Squirrel-li/hear-your-heart/assets/software/資料流程圖.jpg

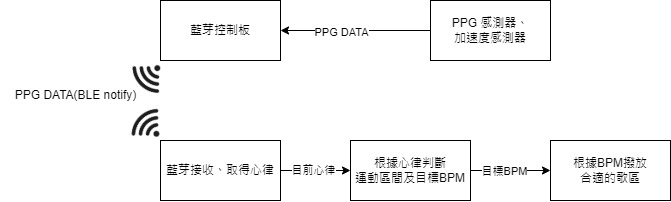
assets/software/資料流程圖.jpg
