Squirrel-li/hear-your-heart/docs/project-overview/system_architecture.png

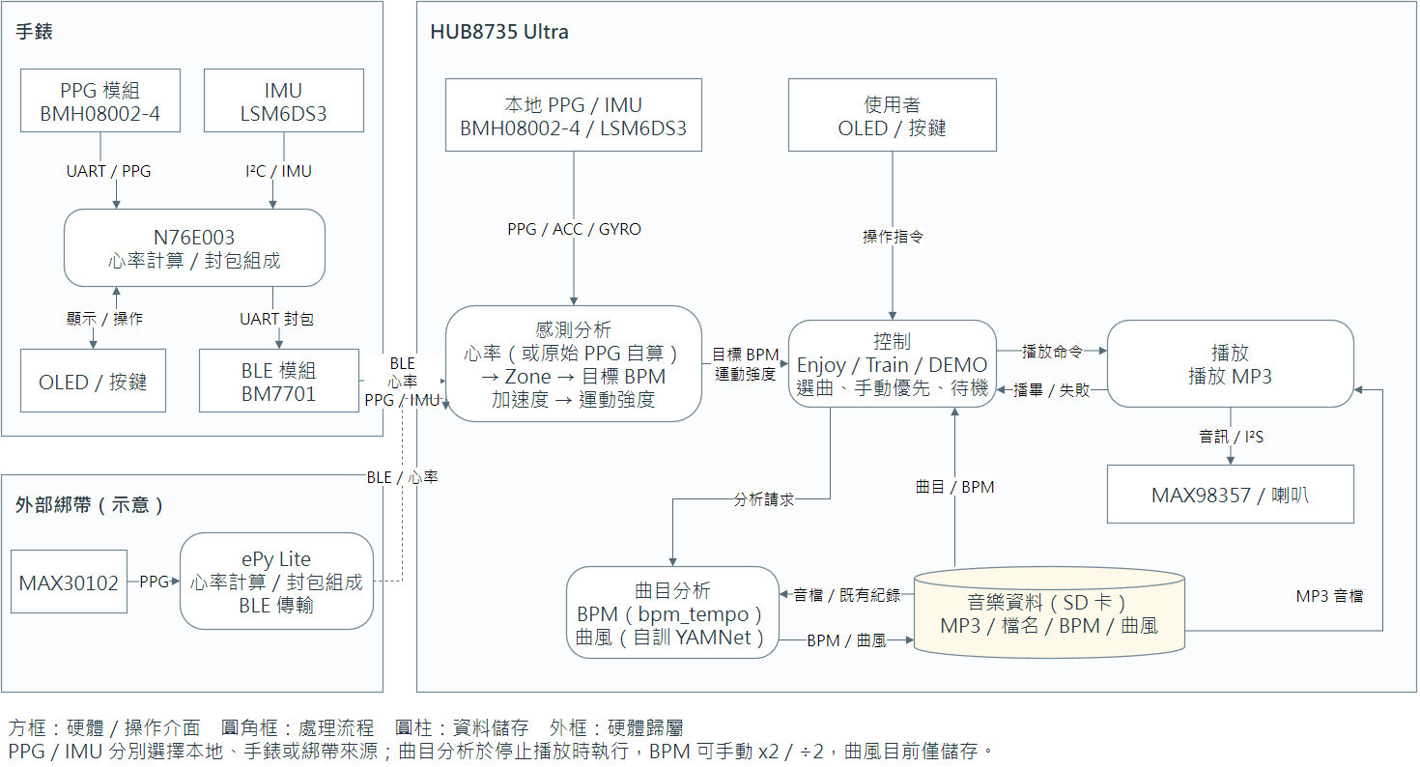
docs/project-overview/system_architecture.png
