Squirrel-li/hear-your-heart/docs/hub8735/hub_ui_steps/02.png

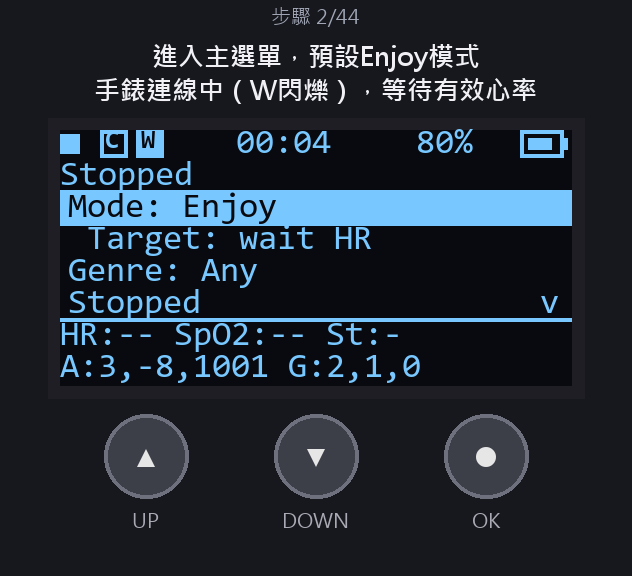
docs/hub8735/hub_ui_steps/02.png
