Squirrel-li/hear-your-heart/docs/hub8735/hub_ui_steps/11.png

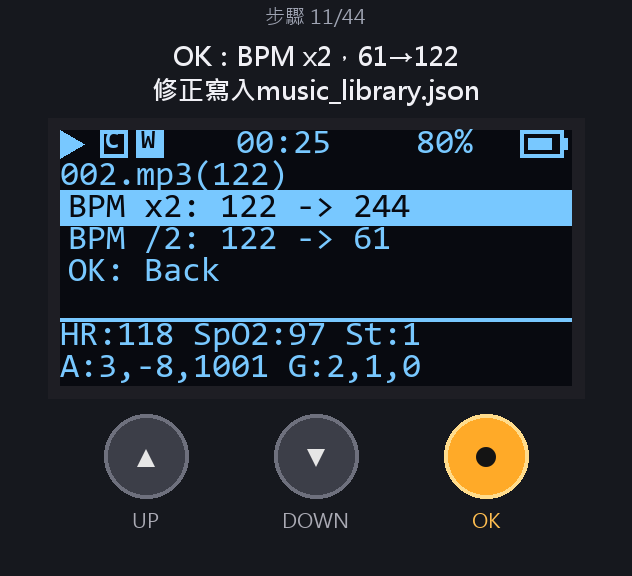
docs/hub8735/hub_ui_steps/11.png
