Squirrel-li/hear-your-heart/docs/hub8735/hub_ui_steps/33.png

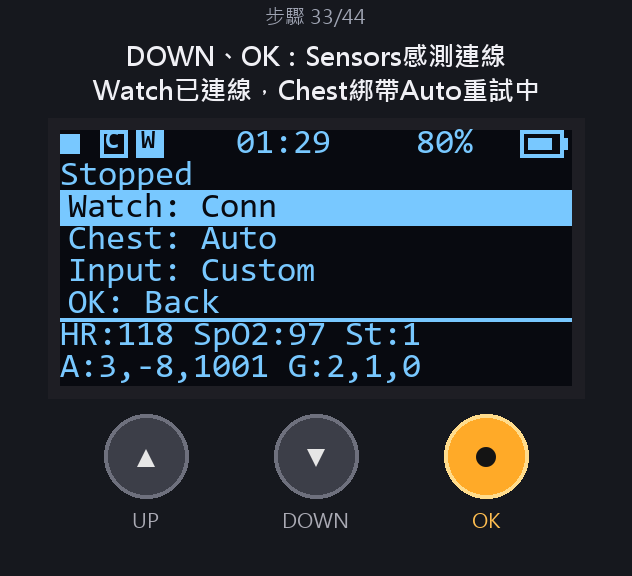
docs/hub8735/hub_ui_steps/33.png
