Squirrel-li/hear-your-heart/docs/hub8735/hub_ui_steps/34.png

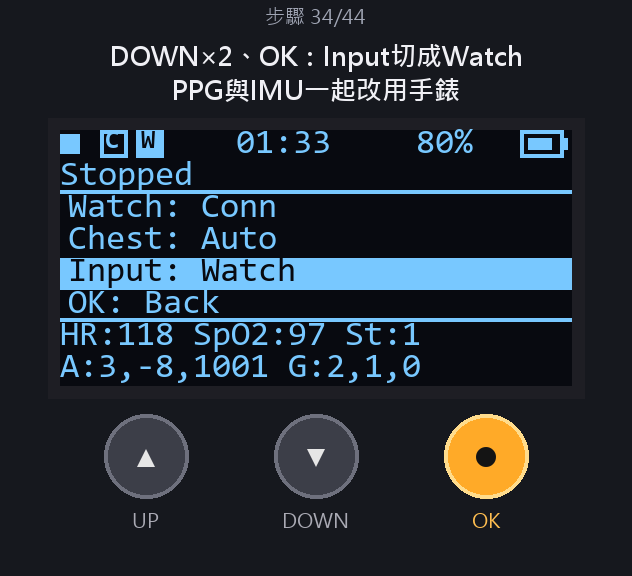
docs/hub8735/hub_ui_steps/34.png
