Squirrel-li/hear-your-heart/docs/hub8735/hub_ui_steps/37.png

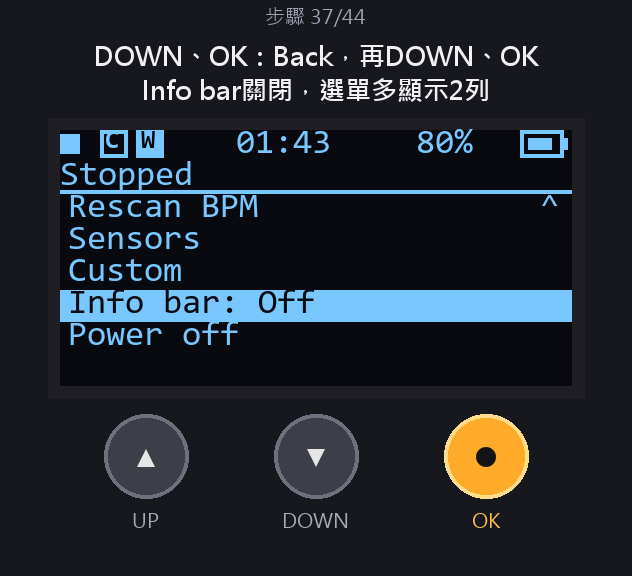
docs/hub8735/hub_ui_steps/37.png
