Squirrel-li/hear-your-heart/docs/hub8735/hub_ui_steps/44.png

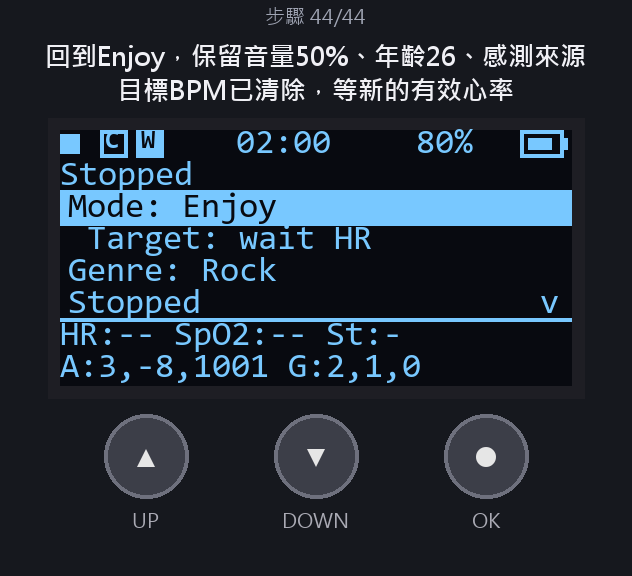
docs/hub8735/hub_ui_steps/44.png
