Squirrel-li/hear-your-heart/docs/hub8735/hub_ui_steps/hub_ui_operation.gif

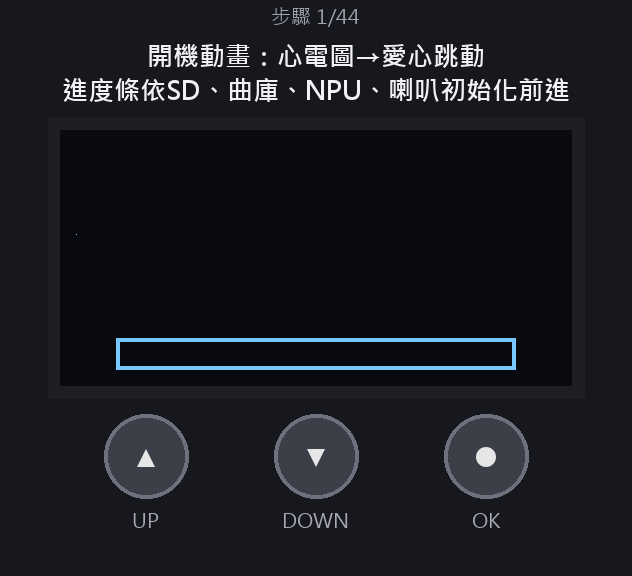
docs/hub8735/hub_ui_steps/hub_ui_operation.gif
