Squirrel-li/hear-your-heart/firmware/n76e003/scripts/ble-test.html

# BM7701 控制與 BLE 測試

本頁由 bm7701.ps1 -Command Web 提供：左側透過腳本控制 UART，右側使用這台電腦的 Bluetooth 測試 BLE 服務。

## 1 · BM7701 UART 控制

正在連接 bm7701.ps1 Web API…

讀取版本 讀取狀態 開始廣播 停止廣播

Bluetooth 名稱設定名稱

功率代碼（0–15）設定功率

網頁不直接開啟 COM；若 API 未連線，請先在 PowerShell 執行 Web 模式。

## 2 · UART → BLE 通知（FFF1）

格式 資料00 01 02 03 04 05 06 07 08 09

發送發送並比對通知

Counter 筆數 間隔（ms）

發送 counter發送並驗證 counter

「比對／驗證」需先在右側連線並開啟 FFF1 通知。UART ACK 只代表模組收到命令，送達與否以 BLE 通知為準。

## 3 · 電腦 BLE 連線

額外 Service UUID（逗號或空白分隔；FFF0 已包含）

選擇 BM7701 並連線斷線讀取所有可讀值

尚未連線

只列出本次授權且 Chrome 允許存取的服務，並非完整 GATT 清單；新增 UUID 後需重新選擇裝置。重新連線後請重新訂閱。

## 4 · 資料與驗證

格式 BLE 寫入資料／通知預期值00 01 02 03 04 05 06 07 08 09

填入固定 10 bytes比對下一筆 FFF1 通知開始驗證 counter結束 counter 並判定

尚未開始比對。先在下方 FFF1 開啟通知，再從 UART 送出資料。

固定資料逐 byte 比對。Counter 格式：42 4D + 16-bit LE 序號（0 起，筆數取左側設定）+ 00 01 02 03 04 05；收齊即自動判定，完整、無重複、無亂序才通過。其他通知不計入。

## 5 · Characteristics

連線後顯示 UUID、屬性與可用操作。

## 6 · 事件日誌

匯出日誌清除畫面日誌離線自我檢查

最多保留最近 2,000 筆；長測試請定期匯出。腳本 UART 事件以 SCRIPT 開頭。
