Squirrel-li/hear-your-heart/firmware/n76e003/application/ble_sensor_motion/public_test_results/windows.csv

record | mode | end_s | reference_center_s | phase | reference_bpm | bpm | valid | absolute_error | reason | quality | ir_bpm | red_bpm
DATA_01_TYPE01 | acc_assisted | 10.024 | 7.523999999999999 | rest_protocol | 76.95593406593406 | 77 | 1 | 0.04406593406594084 | 0 | 100 | 77 | 77
DATA_01_TYPE01 | acc_assisted | 15.036 | 12.536 | rest_protocol | 72.3405017921147 | 72 | 1 | 0.34050179211469356 | 0 | 100 | 70 | 70
DATA_01_TYPE01 | acc_assisted | 20.048 | 17.548 | rest_protocol | 73.32391885254185 | 74 | 1 | 0.6760811474581487 | 0 | 60 | 0 | 75
DATA_01_TYPE01 | acc_assisted | 25.06 | 22.56 | rest_protocol | 77.61560470151562 | 75 | 1 | 2.615604701515622 | 0 | 60 | 76 | 0
DATA_01_TYPE01 | acc_assisted | 30.072 | 27.572 | rest_protocol | 75.48998239584206 | 0 | 0 |  | 2 | 0 | 0 | 0
DATA_01_TYPE01 | acc_assisted | 35.084 | 32.584 | run_protocol | 70.27523548171773 | 67 | 1 | 3.275235481717729 | 0 | 83 | 68 | 66
DATA_01_TYPE01 | acc_assisted | 40.096 | 37.596 | run_protocol | 79.69778582308659 | 0 | 0 |  | 2 | 0 | 0 | 0
DATA_01_TYPE01 | acc_assisted | 45.108 | 42.608 | run_protocol | 83.86281025806029 | 0 | 0 |  | 2 | 0 | 0 | 0
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
