Squirrel-li/hear-your-heart/apps/bmh08002_ppg_analyzer/results/hr1_motion.csv

segment | end_s | fs_hz | bpm | quality | reason | mode | ir_bpm | red_bpm | removed_fraction | module_d3_bpm
1 | 10.005 | 35.7963 | 55.582213483566974 | 0.6125135936392285 | ok | ppg_only | 55.582213483566974 | 55.582213483566974 | 0.0 | 57.0
1 | 12.016 | 35.7963 | 0.0 | 0.0 | contact_or_gain_jump | ppg_only | 0.0 | 0.0 | 0.0 | 57.0
1 | 14.028 | 35.7963 | 59.25273701550065 | 0.6582956041171376 | ok | ppg_only | 58.728376510938695 | 59.777097520062604 | 0.0 | 57.0
1 | 16.039 | 35.7963 | 0.0 | 0.0 | ambiguous_spectrum | ppg_only | 0.0 | 0.0 | 0.0 | 57.0
1 | 18.051 | 35.7963 | 74.98355215235922 | 0.5049871758649533 | ok | ppg_only | 74.45919164779727 | 75.50791265692118 | 0.0 | 57.0
1 | 20.062 | 35.7963 | 0.0 | 0.0 | ambiguous_spectrum | ppg_only | 0.0 | 0.0 | 0.0 | 66.0
1 | 22.073 | 35.7963 | 0.0 | 0.0 | ambiguous_spectrum | ppg_only | 0.0 | 0.0 | 0.0 | 71.0
1 | 24.085 | 35.7963 | 0.0 | 0.0 | ambiguous_spectrum | ppg_only | 0.0 | 0.0 | 0.0 | 71.0
1 | 26.096 | 35.7963 | 60.30145802462455 | 0.6102117137805741 | ok | ppg_only | 60.825818529186506 | 59.777097520062604 | 0.0 | 71.0
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
