Squirrel-li/hear-your-heart/apps/bmh08002_ppg_analyzer/results/hr2_motion.csv

segment | end_s | fs_hz | bpm | quality | reason | mode | ir_bpm | red_bpm | removed_fraction | module_d3_bpm
1 | 10.027 | 35.7716 | 0.0 | 0.0 | contact_or_gain_jump | ppg_only | 0.0 | 0.0 | 0.0 | 73.0
1 | 12.04 | 35.7716 | 0.0 | 0.0 | contact_or_gain_jump | ppg_only | 0.0 | 0.0 | 0.0 | 73.0
1 | 14.053 | 35.7716 | 0.0 | 0.0 | contact_or_gain_jump | ppg_only | 0.0 | 0.0 | 0.0 | 73.0
1 | 16.065 | 35.7716 | 77.55171925710616 | 0.48944241785102627 | ok | ppg_only | 77.55171925710616 | 77.55171925710616 | 0.0 | 73.0
1 | 18.078 | 35.7716 | 0.0 | 0.0 | ambiguous_spectrum | ppg_only | 0.0 | 0.0 | 0.0 | 73.0
1 | 20.091 | 35.7716 | 0.0 | 0.0 | ambiguous_spectrum | ppg_only | 0.0 | 0.0 | 0.0 | 76.0
1 | 22.104 | 35.7716 | 79.64771166946039 | 0.5751282755788939 | ok | ppg_only | 79.64771166946039 | 79.64771166946039 | 0.0 | 80.0
1 | 24.116 | 35.7716 | 75.45572684475194 | 0.47310335031146206 | ok | ppg_only | 75.45572684475194 | 75.45572684475194 | 0.0 | 81.0
1 | 26.129 | 35.7716 | 70.21574581386639 | 0.5498941536758538 | ok | ppg_only | 70.21574581386639 | 70.21574581386639 | 0.0 | 81.0
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
