Squirrel-li/hear-your-heart/firmware/n76e003/application/ble_sensor_motion/test_results/clean_180.csv

time_ms | bpm | raw_bpm | quality | reason | ir_bpm | red_bpm | old_bpm | old_fresh
5012 | 0 | 0 | 0 | 1 | 181 | 181 | 0 | 0
10024 | 180 | 180 | 100 | 0 | 180 | 180 | 0 | 1
15036 | 181 | 181 | 100 | 0 | 181 | 181 | 0 | 0
20048 | 180 | 180 | 100 | 0 | 180 | 180 | 180 | 1
25060 | 180 | 180 | 100 | 0 | 180 | 180 | 180 | 0
30072 | 181 | 181 | 100 | 0 | 181 | 181 | 180 | 1
35084 | 180 | 180 | 100 | 0 | 180 | 180 | 180 | 0
40096 | 181 | 181 | 100 | 0 | 181 | 181 | 180 | 1
45108 | 180 | 180 | 100 | 0 | 180 | 180 | 180 | 0
50120 | 181 | 181 | 100 | 0 | 181 | 180 | 180 | 1
55132 | 181 | 181 | 100 | 0 | 180 | 181 | 180 | 0
