Squirrel-li/hear-your-heart/firmware/n76e003/application/ble_sensor_motion/test_results/clean_45.csv

time_ms | bpm | raw_bpm | quality | reason | ir_bpm | red_bpm | old_bpm | old_fresh
5012 | 0 | 0 | 0 | 1 | 45 | 45 | 0 | 0
10024 | 45 | 45 | 100 | 0 | 45 | 45 | 0 | 1
15036 | 45 | 45 | 100 | 0 | 45 | 45 | 0 | 0
20048 | 45 | 45 | 100 | 0 | 45 | 45 | 45 | 1
25060 | 45 | 45 | 100 | 0 | 45 | 45 | 45 | 0
30072 | 45 | 45 | 100 | 0 | 45 | 45 | 45 | 1
35084 | 46 | 46 | 100 | 0 | 45 | 46 | 45 | 0
40096 | 45 | 45 | 100 | 0 | 45 | 44 | 45 | 1
45108 | 45 | 45 | 100 | 0 | 45 | 45 | 45 | 0
50120 | 45 | 45 | 100 | 0 | 45 | 45 | 45 | 1
55132 | 45 | 45 | 100 | 0 | 45 | 45 | 45 | 0
