Squirrel-li/hear-your-heart/firmware/n76e003/application/ble_sensor_motion/test_results/hr1.csv

time_ms | bpm | raw_bpm | quality | reason | ir_bpm | red_bpm | old_bpm | old_fresh
5033 | 0 | 0 | 0 | 1 | 0 | 0 | 0 | 0
10033 | 56 | 56 | 100 | 0 | 56 | 56 | 0 | 1
15034 | 72 | 72 | 71 | 0 | 75 | 69 | 0 | 0
20034 | 0 | 0 | 0 | 2 | 0 | 0 | 73 | 1
25035 | 60 | 60 | 100 | 0 | 60 | 60 | 73 | 0
30035 | 59 | 59 | 100 | 0 | 58 | 59 | 59 | 1
