Squirrel-li/hear-your-heart/firmware/n76e003/application/ble_sensor_motion/test_results/hr2.csv

time_ms | bpm | raw_bpm | quality | reason | ir_bpm | red_bpm | old_bpm | old_fresh
5051 | 0 | 0 | 0 | 1 | 89 | 91 | 0 | 0
10055 | 70 | 70 | 71 | 0 | 69 | 71 | 0 | 1
15059 | 77 | 81 | 100 | 0 | 80 | 81 | 0 | 0
20063 | 80 | 81 | 100 | 0 | 81 | 81 | 80 | 1
25067 | 73 | 70 | 100 | 0 | 70 | 70 | 80 | 0
30071 | 70 | 69 | 100 | 0 | 68 | 69 | 69 | 1
35075 | 73 | 75 | 100 | 0 | 74 | 75 | 69 | 0
40079 | 69 | 67 | 100 | 0 | 67 | 66 | 71 | 1
45083 | 68 | 68 | 100 | 0 | 68 | 68 | 71 | 0
50087 | 66 | 65 | 100 | 0 | 65 | 65 | 67 | 1
55091 | 65 | 65 | 100 | 0 | 65 | 65 | 67 | 0
61702 | 0 | 0 | 0 | 1 | 72 | 72 | 67 | 0
66705 | 70 | 70 | 100 | 0 | 70 | 70 | 67 | 0
