Squirrel-li/hear-your-heart/firmware/remote_sensor/scripts/ble-test.html

# BM7701 控制與 BLE 測試

本頁由 bm7701.ps1 -Command Web 提供：UART 控制走同一個腳本，BLE 服務測試使用這台電腦的內建 Bluetooth。

## UART 發送資料

格式 資料00 01 02 03 04 05 06 07 08 09

## 1 · BM7701 UART 控制

讀取腳本狀態讀取版本讀取狀態開始廣播停止廣播

Bluetooth 名稱 功率代碼（0–15）

設定名稱設定功率由 UART 發送目前資料到 FFF1由 UART 發送 counter

Counter 筆數 Counter 間隔（ms） 尚未連接 bm7701.ps1 Web API

網頁不直接開啟 COM。若 API 尚未啟動，請先在 PowerShell 執行 Web 模式；本區按鈕只呼叫固定的 BM7701 操作。

## 2 · 電腦接收／BLE 操作

額外 Service UUID（逗號或空白分隔；FFF0 已包含）

選擇 BM7701 並連線斷線讀取所有可讀值匯出日誌離線自我檢查

尚未連線

只列出本次授權且 Chrome 允許存取的服務，並非完整 GATT 清單。新增 UUID 後需重新選擇裝置。請在電腦的 Bluetooth 裝置選擇器選 BM7701；重新連線後請重新訂閱。

## 3 · 資料與驗證

資料格式 寫入資料／通知預期值00 01 02 03 04 05 06 07 08 09

填入固定 10 bytes比對下一筆 FFF1 通知開始驗證 100 筆 FFF1 counter結束 counter 並判定

尚未開始比對。先在下方 FFF1 開啟通知，再從電腦送出資料。

固定資料逐 byte 比對。Counter 格式：42 4D + 16-bit LE 序號（0–99）+ 00 01 02 03 04 05。按「開始驗證」後可按上方「由 UART 發送 counter」；完整、無重複、無亂序才通過。其他通知不計入 FFF1 測試。

## 4 · Characteristics

連線後顯示 UUID、屬性與可用操作。

## 5 · 事件日誌

最多保留最近 2,000 筆；長測試請定期匯出。腳本 UART 事件會以 SCRIPT 顯示，BLE 操作會以 BLE 顯示。
