Squirrel-li/hear-your-heart/firmware/hub8735-ultra/application/embedded_loudspeaker/ControlTask.h

#ifndef CONTROL_TASK_H
#define CONTROL_TASK_H

#include <Arduino.h>
#include <FreeRTOS.h>
#include <task.h>
#include <queue.h>

#include "debug.h"
#include "globalData.h"

void controlTask(void* parameter);

// User age (HRmax) kept in flash; controlTask owns it. setup() reads it before the tasks start.
int settingsLoadAge();

#endif // CONTROL_TASK_H
