Squirrel-li/hear-your-heart/firmware/hub8735-ultra/application/embedded_loudspeaker/UITask.cpp

#include "UITask.h"

#include "debug.h"
#include "globalData.h"
#include "music_library.h"
#include "oled_sh1106.h"
#include "motion_level.h"
#include "train_plan.h"

namespace {

constexpr const char* TAG = "UI";
uint32_t droppedCommands = 0;

// OLED on Wire (I2C0: SDA=D3/PE4, SCL=D4/PE3).
constexpr uint8_t OLED_ADDRESS = 0x3C;

// Buttons wired between pin and GND (internal pull-up, pressed = LOW).
constexpr uint8_t PIN_UP = 8;
constexpr uint8_t PIN_DOWN = 9;
constexpr uint8_t PIN_OK = 10;
constexpr uint8_t PIN_BATTERY = 2;  // ADC0, battery through a /2 divider

constexpr uint32_t POLL_MS = 10;
constexpr uint32_t REDRAW_MS = 50;
constexpr uint32_t MARQUEE_MS = 300;  // a long name scrolls one column per step
constexpr int MARQUEE_GAP = 3;        // blank columns between the end and the restart of a scrolled name
// Full resend (and placement registers) so a glitched I2C transfer heals by itself.
constexpr uint32_t REFRESH_MS = 2000;

// Layout (6x8 font, 21 columns, 8 rows aligned to the panel's 8-pixel pages so an
// update only resends the pages that changed): icon row, now playing, 4 menu rows, 2 info
// rows (6 menu rows with the info bar off). The font leaves the bottom pixel row of each cell
// empty, which holds the lines.
constexpr int16_t ICON_Y = 0;
constexpr int16_t SONG_Y = 8;
constexpr int16_t HEADER_LINE_Y = 15;
constexpr int16_t MENU_Y = 16;
constexpr int16_t DIVIDER_Y = 47;
constexpr int16_t STATUS_Y[2] = {48, 56};

// Rows depend on the mode: TopGenre in Enjoy / Train, TopSongBpm while a library song
// plays. The Top cursor is a row; topItemAt() maps it to an item.
enum TopItem : uint8_t {
    TopMode,
    TopGenre,
    TopPlay,
    TopSongBpm,
    TopSongs,
    TopStop,
    TopVolume,
    TopAge,
    TopBpmAnalysis,
    TopBle,
    TopInput,
    TopDebug,
    TopPowerOff,
    TopCount
};

// Top: mode, play/pause, stop, volume, and BPM analysis. ModeList / VolumeList: pick a value with OK, which also leaves the list.
enum class Screen : uint8_t {
    Top,
    ModeList,
    PlanList,      // Train plans, opened when Train is picked in ModeList
    VolumeList,
    GenreList,     // preferred genre for Enjoy / Train; OK picks it and leaves
    BpmStatus,
    SongList,
    SongMenu,      // one song: [Play] / BPM x2 / BPM /2 / Back (Play only from SongList in Manual)
    BleList,       // Watch / Chest link (OK toggles Auto/Off); Back
    CustomList,    // opened when Top Input reaches Custom: PPG / IMU (OK cycles each); Back
    PowerConfirm,  // Cancel / Power off
    AgeEdit,       // Up/Down change the age, OK saves it (controlTask writes flash)
    DebugList,     // Info bar (OK toggles) / Analysis / Back
    AnalysisList,  // Reanalyze all / Clear all (both open AnalysisConfirm) / Clear one song (SongList) / Back
    AnalysisConfirm  // Cancel / Confirm for the action picked in AnalysisList
};

constexpr uint8_t MODE_COUNT = 4;  // PlayMode values in order: Enjoy, Train, Manual, Demo
constexpr uint8_t SOURCE_COUNT = 3;  // Chest, Watch, Local
constexpr uint8_t POWER_CONFIRM_COUNT = 2;
constexpr uint8_t VOLUME_STEP = 10;
constexpr uint8_t VOLUME_COUNT = 100 / VOLUME_STEP + 1;

struct Button {
    uint8_t pin;
    uint8_t history;  // last 8 samples, 1 = pressed
    bool down;
};

OledSh1106 oled(&Wire, OLED_ADDRESS);

Button buttons[3] = {{PIN_UP, 0, false}, {PIN_DOWN, 0, false}, {PIN_OK, 0, false}};

Screen screen = Screen::Top;
uint16_t cursor = TopMode;
uint16_t menuTop = 0;

// Mirrors the choice sent to analysisTask (PPG starts on Watch, IMU on Local).
SensorSource ppgSource = SensorSource::Watch;
SensorSource imuSource = SensorSource::Local;
bool customInput = true;  // PPG and IMU picked separately; the boot pair (Watch, Local) differs

// Reported by controlTask / audioTask.
PlayMode playMode = PlayMode::Enjoy;
uint8_t trainPlan = 0;
uint8_t trainStage = TRAIN_STAGE_DONE;
uint16_t trainRemainingS = 0;
bool trainDone = false;  // shown until the mode changes again
uint16_t targetBpm = 0;  // Enjoy: 0 until a valid heart rate gives a target
uint8_t motionLevel = MOTION_LEVEL_NONE;  // Demo
AudioState audioState = AudioState::Stopped;
char nowPlaying[AUDIO_FILENAME_MAX] = "";
// ponytail: Volume is mirrored from menu changes only; the serial "volume" command
// can make it differ. Have audioTask report the volume if that matters.
uint8_t volumePercent = DEFAULT_VOLUME_PERCENT;
BpmAnalysisState bpmAnalysisState = BpmAnalysisState::Idle;
BpmAnalysisMode bpmAnalysisMode = BpmAnalysisMode::NewOrUnknown;
uint16_t bpmAnalysisCurrent = 0;
uint16_t bpmAnalysisTotal = 0;
uint16_t bpmAnalysisSucceeded = 0;
uint16_t bpmAnalysisFailed = 0;
char bpmAnalysisFile[AUDIO_FILENAME_MAX] = "";

uint32_t lastRefreshMs = 0;
bool infoBar = true;  // bottom HR / IMU rows; not saved, back on after reboot
int16_t songMenuIndex = -1;     // musicLibrary index shown in SongMenu
bool songMenuFromList = false;  // SongMenu opened from SongList (Back returns to the list)
enum SongMenuItem : uint8_t { SongPlay, SongDouble, SongHalve, SongBack };
bool powerOffRequested = false;  // set by the confirm screen, handled in the UITask loop
uint8_t ageEdit = USER_AGE_DEFAULT;  // value shown while AgeEdit is open
uint8_t preferredGenre = 0;  // mirrors the SetGenre sent to controlTask (GENRE_CHOICES index)
uint32_t okPressMs = 0;  // OKT latency log: time of the last OK press, 0 = none
// BpmStatus rows: state, progress, file, Back. View only: a scan is cancelled by serial "bpm cancel" or standby.
constexpr uint16_t BPM_STATUS_BACK = 3;
enum DebugItem : uint8_t { DebugInfoBar, DebugAnalysis, DebugBack };
enum AnalysisItem : uint8_t { AnalysisReanalyzeAll, AnalysisClearAll, AnalysisClearOne, AnalysisBack };
bool songListClear = false;  // SongList opened from AnalysisClearOne: OK on a song clears its BPM and genre
uint8_t analysisConfirmItem = AnalysisReanalyzeAll;  // action AnalysisConfirm asks about

// Reported by BLETask, index = SensorSource (Chest, Watch).
BleLinkState bleLink[2] = {BleLinkState::Down, BleLinkState::Down};
bool bleAuto[2] = {true, true};
bool havePpg = false;
uint16_t heartRate = 0;
uint8_t spo2 = 0;
uint8_t ppgStatus = 0;
bool haveAcc = false;
bool haveGyro = false;
int16_t acc[3] = {0, 0, 0};
int16_t gyro[3] = {0, 0, 0};

const char* sourceLabel(SensorSource source)
{
    return source == SensorSource::Chest ? "Chest" : source == SensorSource::Watch ? "Watch" : "Local";
}

const char* modeName(PlayMode mode)
{
    switch (mode) {
    case PlayMode::Enjoy: return "Enjoy";
    case PlayMode::Train: return "Train";
    case PlayMode::Demo: return "Demo";
    default: return "Manual";
    }
}

// Library index of the song being played or paused, -1 when stopped or not in the library (DEMO tracks).
int16_t playingLibraryIndex()
{
    if (audioState == AudioState::Stopped) return -1;
    for (size_t i = 0; i < musicLibrary.count && i < MUSIC_LIBRARY_MAX; ++i)
        if (strcmp(musicLibrary.entries[i].file, nowPlaying) == 0) return static_cast<int16_t>(i);
    return -1;
}

// x2 / /2 target for a song's BPM, 0 when unknown or outside 30..300.
uint16_t scaledBpm(uint16_t bpm, bool doubled)
{
    if (bpm == 0) return 0;
    const uint16_t v = doubled ? static_cast<uint16_t>(bpm * 2) : static_cast<uint16_t>((bpm + 1) / 2);
    return v >= 30 && v <= 300 ? v : 0;
}

// Picking a song to play is Manual only; automatic modes can view the list and fix BPM (x2 / /2).
bool songMenuHasPlay() { return songMenuFromList && playMode == PlayMode::Manual; }
uint16_t songMenuBackRow() { return songMenuHasPlay() ? 3 : 2; }  // the menu opens on Back
uint8_t songMenuItemAt(uint16_t row) { return static_cast<uint8_t>(songMenuHasPlay() ? row : row + 1); }

bool topItemVisible(uint8_t item)
{
    if (item == TopSongBpm) return playingLibraryIndex() >= 0;
    if (item == TopGenre) return playMode == PlayMode::Enjoy || playMode == PlayMode::Train;
    return true;
}

uint16_t topRowCount()
{
    uint16_t n = 0;
    for (uint8_t i = 0; i < TopCount; ++i) n += topItemVisible(i) ? 1 : 0;
    return n;
}

uint8_t topItemAt(uint16_t row)
{
    for (uint8_t i = 0; i < TopCount; ++i) {
        if (!topItemVisible(i)) continue;
        if (row-- == 0) return i;
    }
    return TopMode;
}

uint16_t topRowOf(uint8_t item)
{
    uint16_t row = 0;
    for (uint8_t i = 0; i < item && i < TopCount; ++i) row += topItemVisible(i) ? 1 : 0;
    return topItemVisible(item) ? row : 0;
}

// Entries are added or removed only while musicBpmAnalysisBusy (directory scan, clear); the list
// is not offered then. Row 0 is Back, row i + 1 is song i (UP from the first song reaches Back).
uint16_t songCount()
{
    const size_t n = musicLibrary.count > MUSIC_LIBRARY_MAX ? MUSIC_LIBRARY_MAX : musicLibrary.count;
    return static_cast<uint16_t>(n + 1);
}

bool bpmAnalysisActive()
{
    return bpmAnalysisState == BpmAnalysisState::Queued || bpmAnalysisState == BpmAnalysisState::Running;
}

uint16_t itemCount()
{
    switch (screen) {
    case Screen::ModeList: return MODE_COUNT;
    case Screen::PlanList: return TRAIN_PLAN_COUNT;
    case Screen::VolumeList: return VOLUME_COUNT;
    case Screen::GenreList: return GENRE_CHOICE_COUNT;
    case Screen::BpmStatus: return BPM_STATUS_BACK + 1;
    case Screen::AgeEdit: return 1;
    case Screen::SongList: return songCount();
    case Screen::SongMenu: return songMenuHasPlay() ? 4 : 3;
    case Screen::BleList: return 3;
    case Screen::CustomList: return 3;
    case Screen::PowerConfirm: return POWER_CONFIRM_COUNT;
    case Screen::DebugList: return DebugBack + 1;
    case Screen::AnalysisList: return AnalysisBack + 1;
    case Screen::AnalysisConfirm: return 2;
    default: return topRowCount();
    }
}
// True once on the sample that completes a stable press (40 ms debounce).
bool buttonPressed(Button& b)
{
    b.history = static_cast<uint8_t>((b.history << 1) | (digitalRead(b.pin) == LOW));
    if ((b.history & 0x0F) == 0x0F && !b.down) {
        b.down = true;
        return true;
    }
    if ((b.history & 0x0F) == 0) b.down = false;
    return false;
}

const char* screenName(Screen value)
{
    switch (value) {
    case Screen::Top: return "Top";
    case Screen::ModeList: return "ModeList";
    case Screen::PlanList: return "PlanList";
    case Screen::VolumeList: return "VolumeList";
    case Screen::GenreList: return "GenreList";
    case Screen::BpmStatus: return "BpmStatus";
    case Screen::SongList: return "SongList";
    case Screen::SongMenu: return "SongMenu";
    case Screen::BleList: return "BleList";
    case Screen::CustomList: return "CustomList";
    case Screen::PowerConfirm: return "PowerConfirm";
    case Screen::AgeEdit: return "AgeEdit";
    case Screen::DebugList: return "DebugList";
    case Screen::AnalysisList: return "AnalysisList";
    case Screen::AnalysisConfirm: return "AnalysisConfirm";
    }
    return "?";
}

const char* topItemName(uint8_t item)
{
    switch (item) {
    case TopMode: return "Mode";
    case TopGenre: return "Genre";
    case TopPlay: return "Play/Pause";
    case TopSongBpm: return "Song BPM";
    case TopSongs: return "Songs";
    case TopStop: return "Stop";
    case TopVolume: return "Volume";
    case TopAge: return "Age";
    case TopBpmAnalysis: return "BPM analysis";
    case TopBle: return "BLE";
    case TopInput: return "Input";
    case TopDebug: return "Debug";
    case TopPowerOff: return "Power off";
    }
    return "?";
}

const char* linkLabel(BleLinkState state)
{
    return state == BleLinkState::Up ? "Conn" : state == BleLinkState::Connecting ? "Scan" : "--";
}

// BLETask reports the result; the menu shows it on the next Ble update.
void sendBleCommand(BleCommandType type, uint8_t device)
{
    const BleCmdElement command{type, static_cast<SensorSource>(device)};
    if (bleCmdQueue == nullptr || xQueueSend(bleCmdQueue, &command, 0) != pdPASS) {
        ++droppedCommands;
        LOGW(TAG, "BLE command queue full; command %d dropped", static_cast<int>(type));
        return;
    }
    LOGI(TAG, "-> BLE: command %d device %u", static_cast<int>(type), static_cast<unsigned>(device));
}

bool sendCommand(UiCommandType type, uint8_t volume = 0, PlayMode mode = PlayMode::Enjoy,
                 int16_t songIndex = -1, SensorSource source = SensorSource::Chest, uint8_t plan = 0,
                 uint16_t bpm = 0, uint8_t age = 0, uint8_t genre = 0)
{
    UiCommandElement command{};
    command.age = age;
    command.genre = genre;
    command.bpm = bpm;
    command.command = type;
    command.trainPlan = plan;
    command.source = source;
    command.volumePercent = volume;
    command.mode = mode;
    command.songIndex = songIndex;
    if (uiCmdQueue == nullptr || xQueueSend(uiCmdQueue, &command, 0) != pdPASS) {
        ++droppedCommands;
        LOGW(TAG, "control command queue full; command %d dropped (total dropped %lu)", static_cast<int>(type),
             static_cast<unsigned long>(droppedCommands));
        return false;
    }
    LOGD(TAG, "-> control: command %d (volume=%u mode=%s)", static_cast<int>(type), static_cast<unsigned>(volume),
         modeName(mode));
    return true;
}

// The mirror changes only once controlTask has the command.
bool setSensorSource(bool isPpg, SensorSource source)
{
    if (!sendCommand(isPpg ? UiCommandType::SetPpgSource : UiCommandType::SetImuSource, 0, PlayMode::Enjoy, -1,
                     source))
        return false;
    (isPpg ? ppgSource : imuSource) = source;
    return true;
}

void openList(Screen list, uint16_t selected)
{
    LOGD(TAG, "screen %s -> %s (cursor %u)", screenName(screen), screenName(list), static_cast<unsigned>(selected));
    screen = list;
    cursor = selected;
    menuTop = 0;
}

void backToTop(TopItem item)
{
    LOGD(TAG, "screen %s -> Top (cursor %s)", screenName(screen), topItemName(item));
    screen = Screen::Top;
    cursor = topRowOf(item);
    menuTop = 0;
}

void showBpmStatus()
{
    screen = Screen::BpmStatus;
    cursor = BPM_STATUS_BACK;
    menuTop = 0;
}

// Starts a scan and shows its progress; while one is queued or running, only shows it.
void startBpmScan(BpmAnalysisMode mode)
{
    if (bpmAnalysisActive()) {
        LOGD(TAG, "BPM analysis already active; showing status");
        showBpmStatus();
        return;
    }
    LOGI(TAG, "BPM %s requested from menu", mode == BpmAnalysisMode::All ? "reanalyze all" : "rescan");
    bpmAnalysisMode = mode;
    bpmAnalysisState = BpmAnalysisState::Queued;
    bpmAnalysisCurrent = 0;
    bpmAnalysisTotal = 0;
    bpmAnalysisSucceeded = 0;
    bpmAnalysisFailed = 0;
    bpmAnalysisFile[0] = 0;
    if (!sendCommand(mode == BpmAnalysisMode::All ? UiCommandType::ReanalyzeAllBpm
                                                  : UiCommandType::AnalyzeNewOrUnknownBpm)) {
        bpmAnalysisState = BpmAnalysisState::Failed;
        bpmAnalysisFailed = 1;
    }
    showBpmStatus();
}

// Long OK: leave the current list one level up without applying its highlighted row.
void goBack()
{
    LOGI(TAG, "OK held: back from %s", screenName(screen));
    switch (screen) {
    case Screen::Top: break;
    case Screen::ModeList: backToTop(TopMode); break;
    case Screen::PlanList: openList(Screen::ModeList, static_cast<uint8_t>(PlayMode::Train)); break;
    case Screen::VolumeList: backToTop(TopVolume); break;
    case Screen::GenreList: backToTop(TopGenre); break;
    case Screen::AgeEdit: backToTop(TopAge); break;  // the edit is dropped
    case Screen::BpmStatus: backToTop(TopBpmAnalysis); break;
    case Screen::SongList:
        if (songListClear) openList(Screen::AnalysisList, AnalysisClearOne);
        else backToTop(TopSongs);
        break;
    case Screen::SongMenu:
        if (songMenuFromList && songMenuIndex >= 0) openList(Screen::SongList, static_cast<uint16_t>(songMenuIndex + 1));
        else backToTop(songMenuFromList ? TopSongs : TopSongBpm);
        break;
    case Screen::BleList: backToTop(TopBle); break;
    case Screen::CustomList: backToTop(TopInput); break;
    case Screen::PowerConfirm: backToTop(TopPowerOff); break;
    case Screen::DebugList: backToTop(TopDebug); break;
    case Screen::AnalysisList: openList(Screen::DebugList, DebugAnalysis); break;
    case Screen::AnalysisConfirm: openList(Screen::AnalysisList, analysisConfirmItem); break;
    }
}

void activateItem()
{
    LOGI(TAG, "OK pressed: screen=%s cursor=%u%s%s", screenName(screen), static_cast<unsigned>(cursor),
         screen == Screen::Top ? " item=" : "", screen == Screen::Top ? topItemName(topItemAt(cursor)) : "");
    switch (screen) {
    case Screen::ModeList:
        if (static_cast<PlayMode>(cursor) == PlayMode::Train) {
            openList(Screen::PlanList, trainPlan);
            break;
        }
        sendCommand(UiCommandType::SetMode, 0, static_cast<PlayMode>(cursor));
        backToTop(TopMode);
        break;
    case Screen::PlanList:
        sendCommand(UiCommandType::SetMode, 0, PlayMode::Train, -1, SensorSource::Chest, static_cast<uint8_t>(cursor));
        backToTop(TopMode);
        break;
    case Screen::VolumeList:
        backToTop(TopVolume);
        break;
    case Screen::GenreList:
        if (cursor != preferredGenre &&
            sendCommand(UiCommandType::SetGenre, 0, PlayMode::Enjoy, -1, SensorSource::Chest, 0, 0, 0,
                        static_cast<uint8_t>(cursor))) {
            preferredGenre = static_cast<uint8_t>(cursor);
        }
        backToTop(TopGenre);
        break;
    case Screen::AgeEdit:
        if (ageEdit != userInfo.age) {
            LOGI(TAG, "age %d -> %u requested", userInfo.age, static_cast<unsigned>(ageEdit));
            sendCommand(UiCommandType::SetAge, 0, PlayMode::Enjoy, -1, SensorSource::Chest, 0, 0, ageEdit);
        }
        backToTop(TopAge);
        break;
    case Screen::BpmStatus:
        backToTop(TopBpmAnalysis);  // the scan keeps running in the background
        break;
    case Screen::SongList:
        if (cursor >= 1 && cursor <= musicLibrary.count && songListClear) {
            // Stays open: the row shows "--" once audioTask has saved it.
            sendCommand(UiCommandType::SetSongBpm, 0, PlayMode::Enjoy, static_cast<int16_t>(cursor - 1));
        } else if (cursor >= 1 && cursor <= musicLibrary.count) {
            songMenuIndex = static_cast<int16_t>(cursor - 1);
            songMenuFromList = true;
            openList(Screen::SongMenu, songMenuBackRow());
        } else if (songListClear) {
            openList(Screen::AnalysisList, AnalysisClearOne);
        } else {
            backToTop(TopSongs);
        }
        break;
    case Screen::SongMenu: {
        const uint8_t item = songMenuItemAt(cursor);
        const bool valid = songMenuIndex >= 0 && songMenuIndex < static_cast<int16_t>(musicLibrary.count);
        if (item == SongPlay && valid) {
            sendCommand(UiCommandType::PlaySong, 0, PlayMode::Enjoy, songMenuIndex);
            backToTop(TopSongs);
        } else if ((item == SongDouble || item == SongHalve) && valid) {
            // Stays open: audioTask saves the library and the label shows the new value.
            const uint16_t bpm = scaledBpm(musicLibrary.entries[songMenuIndex].bpm, item == SongDouble);
            if (bpm != 0) sendCommand(UiCommandType::SetSongBpm, 0, PlayMode::Enjoy, songMenuIndex, SensorSource::Chest, 0, bpm);
        } else if (songMenuFromList && valid) {
            openList(Screen::SongList, static_cast<uint16_t>(songMenuIndex + 1));
        } else {
            backToTop(songMenuFromList ? TopSongs : TopSongBpm);
        }
        break;
    }
    case Screen::BleList:
        if (cursor >= 2) {
            backToTop(TopBle);
        } else {
            // Watch row first; Auto keeps (re)connecting, Disconnect drops the link and turns Auto off.
            const uint8_t device = cursor == 0 ? 1 : 0;
            sendBleCommand(bleAuto[device] ? BleCommandType::Disconnect : BleCommandType::SetAuto, device);
        }
        break;
    case Screen::CustomList:
        if (cursor >= 2) {
            backToTop(TopInput);
        } else {
            // OK cycles PPG or IMU alone (Chest -> Watch -> Local).
            const bool isPpg = cursor == 0;
            const SensorSource current = isPpg ? ppgSource : imuSource;
            setSensorSource(isPpg, static_cast<SensorSource>((static_cast<uint8_t>(current) + 1) % SOURCE_COUNT));
        }
        break;
    case Screen::PowerConfirm:
        // Standby starts only once controlTask has the command.
        if (cursor == 1 && sendCommand(UiCommandType::PowerOff)) powerOffRequested = true;
        else backToTop(TopPowerOff);
        break;
    case Screen::DebugList:
        if (cursor == DebugInfoBar) infoBar = !infoBar;
        else if (cursor == DebugAnalysis) openList(Screen::AnalysisList, 0);
        else backToTop(TopDebug);
        break;
    case Screen::AnalysisList:
        if (cursor == AnalysisBack) {
            openList(Screen::DebugList, DebugAnalysis);
        } else if (cursor == AnalysisClearOne) {
            if (musicLibraryReady && !musicBpmAnalysisBusy && musicLibrary.count > 0) {
                songListClear = true;
                openList(Screen::SongList, 1);
            }
        } else {
            analysisConfirmItem = static_cast<uint8_t>(cursor);
            openList(Screen::AnalysisConfirm, 0);  // default to Cancel: both drop the user's BPM corrections
        }
        break;
    case Screen::AnalysisConfirm:
        if (cursor == 0) {
            openList(Screen::AnalysisList, analysisConfirmItem);
        } else if (analysisConfirmItem == AnalysisReanalyzeAll) {
            startBpmScan(BpmAnalysisMode::All);
        } else {
            LOGI(TAG, "clear all BPM / genre results requested from menu");
            sendCommand(UiCommandType::ClearAnalysisResults);  // audioTask cancels a running scan first
            openList(Screen::AnalysisList, AnalysisClearAll);
        }
        break;
    default:
        switch (topItemAt(cursor)) {
        case TopMode:
            openList(Screen::ModeList, static_cast<uint8_t>(playMode));
            break;
        case TopGenre:
            openList(Screen::GenreList, preferredGenre);
            break;
        case TopPlay:
            if (audioState == AudioState::Playing) sendCommand(UiCommandType::Pause);
            else if (audioState == AudioState::Paused) sendCommand(UiCommandType::Resume);
            break;
        case TopSongBpm:
            songMenuIndex = playingLibraryIndex();
            songMenuFromList = false;
            if (songMenuIndex >= 0) openList(Screen::SongMenu, songMenuBackRow());
            break;
        case TopSongs:
            if (musicLibraryReady && !musicBpmAnalysisBusy && musicLibrary.count > 0) {
                songListClear = false;
                openList(Screen::SongList, 1);  // first song
            } else {
                LOGD(TAG, "song list unavailable (ready=%d busy=%d count=%u)", musicLibraryReady ? 1 : 0,
                     musicBpmAnalysisBusy ? 1 : 0, static_cast<unsigned>(musicLibrary.count));
            }
            break;
        case TopStop:
            sendCommand(UiCommandType::Stop);
            break;
        case TopVolume:
            openList(Screen::VolumeList, 0);
            break;
        case TopAge:
            ageEdit = static_cast<uint8_t>(userInfo.age);
            openList(Screen::AgeEdit, 0);
            break;
        case TopBpmAnalysis:
            // One-button rescan: new / replaced / unknown only; reanalyze-all and clear are under Debug.
            startBpmScan(BpmAnalysisMode::NewOrUnknown);
            break;
        case TopBle:
            openList(Screen::BleList, 0);
            break;
        case TopInput:
            // OK cycles Watch -> Chest -> Local (PPG and IMU together) -> Custom, which opens the PPG / IMU list.
            if (customInput) {
                const bool ppgOk = setSensorSource(true, SensorSource::Watch);
                // A dropped command leaves PPG and IMU apart: they stay Custom.
                customInput = !(setSensorSource(false, SensorSource::Watch) && ppgOk);
            } else if (ppgSource == SensorSource::Local) {
                customInput = true;
                openList(Screen::CustomList, 0);
            } else {
                const SensorSource s = ppgSource == SensorSource::Watch ? SensorSource::Chest : SensorSource::Local;
                const bool ppgOk = setSensorSource(true, s);
                customInput = !(setSensorSource(false, s) && ppgOk);
            }
            break;
        case TopDebug:
            openList(Screen::DebugList, 0);
            break;
        case TopPowerOff:
            openList(Screen::PowerConfirm, 0);  // default to Cancel against a stray press
            break;
        }
        break;
    }
}

void applyUpdate(const UiUpdateElement& update)
{
    // OKT: state updates within 5 s of an OK press (sensor / BLE / target streams skipped).
    if (okPressMs != 0 && (uint32_t)(millis() - okPressMs) < 5000 && update.type != UiUpdateType::Sensor &&
        update.type != UiUpdateType::Acc && update.type != UiUpdateType::Gyro && update.type != UiUpdateType::Ble &&
        update.type != UiUpdateType::Analysis && update.type != UiUpdateType::Motion) {
        LOGI(TAG, "OKT 4 UI update type=%u (+%lu ms since OK)", static_cast<unsigned>(update.type),
             static_cast<unsigned long>(millis() - okPressMs));
    }
    switch (update.type) {
    case UiUpdateType::Ble:
        for (uint8_t i = 0; i < 2; ++i) {
            const BleLinkState state = static_cast<BleLinkState>(update.bleLink[i]);
            if (state != bleLink[i]) LOGI(TAG, "BLE %s shown as %s", i == 0 ? "chest" : "watch", linkLabel(state));
            bleLink[i] = state;
            bleAuto[i] = update.bleAuto[i] != 0;
        }
        break;
    case UiUpdateType::Sensor:
        LOGT(TAG, "update: HR=%u SpO2=%u status=%u", static_cast<unsigned>(update.heartRateBpm),
             static_cast<unsigned>(update.spo2), static_cast<unsigned>(update.sensorStatus));
        havePpg = true;
        heartRate = update.heartRateBpm;
        spo2 = update.spo2;
        ppgStatus = update.sensorStatus;
        break;
    case UiUpdateType::Acc:
        LOGT(TAG, "update: Acc %d,%d,%d", update.acc[0], update.acc[1], update.acc[2]);
        haveAcc = true;
        for (uint8_t i = 0; i < 3; i++) acc[i] = update.acc[i];
        break;
    case UiUpdateType::Gyro:
        LOGT(TAG, "update: Gyro %d,%d,%d", update.gyro[0], update.gyro[1], update.gyro[2]);
        haveGyro = true;
        for (uint8_t i = 0; i < 3; i++) gyro[i] = update.gyro[i];
        break;
    case UiUpdateType::Mode: {
        LOGI(TAG, "mode shown: %s", modeName(static_cast<PlayMode>(update.mode)));
        const uint8_t item = topItemAt(cursor);  // rows change with the mode; keep the highlighted item
        playMode = static_cast<PlayMode>(update.mode);
        trainDone = false;
        if (screen == Screen::Top) cursor = topRowOf(item);
        if (screen == Screen::SongMenu) cursor = songMenuBackRow();  // the Play row comes and goes with Manual
        break;
    }
    case UiUpdateType::Analysis:
        targetBpm = update.targetBpm;
        break;
    case UiUpdateType::Motion:
        motionLevel = update.activityLevel;
        break;
    case UiUpdateType::Train:
        LOGD(TAG, "train plan=%u stage=%u left=%us", static_cast<unsigned>(update.trainPlan),
             static_cast<unsigned>(update.trainStage), static_cast<unsigned>(update.trainRemainingS));
        trainPlan = update.trainPlan < TRAIN_PLAN_COUNT ? update.trainPlan : 0;
        trainStage = update.trainStage;
        trainRemainingS = update.trainRemainingS;
        trainDone = trainStage == TRAIN_STAGE_DONE;
        break;
    case UiUpdateType::Audio:
        LOGD(TAG, "audio state=%u file=%s", static_cast<unsigned>(update.audioState), update.filename);
        if (audioState != static_cast<AudioState>(update.audioState)) {
            // Starting/stopping playback loads the SD and decoder and is when the bus glitches
            // were seen; repair the panel shortly after rather than up to REFRESH_MS later.
            lastRefreshMs = millis() - REFRESH_MS + 300;
        }
        {
            const uint8_t item = topItemAt(cursor);  // TopSongBpm comes and goes with playback; keep the highlighted item
            audioState = static_cast<AudioState>(update.audioState);
            if (update.filename[0] != 0) {
                memcpy(nowPlaying, update.filename, sizeof(nowPlaying));
                nowPlaying[sizeof(nowPlaying) - 1] = 0;
            }
            if (screen == Screen::Top) cursor = topRowOf(item);
        }
        break;
    case UiUpdateType::BpmAnalysis:
        LOGD(TAG, "BPM analysis update: state=%u %u/%u ok=%u fail=%u %s", static_cast<unsigned>(update.bpmAnalysisState),
             static_cast<unsigned>(update.bpmAnalysisCurrent), static_cast<unsigned>(update.bpmAnalysisTotal),
             static_cast<unsigned>(update.bpmAnalysisSucceeded), static_cast<unsigned>(update.bpmAnalysisFailed),
             update.filename);
        bpmAnalysisState = update.bpmAnalysisState;
        bpmAnalysisMode = update.bpmAnalysisMode;
        bpmAnalysisCurrent = update.bpmAnalysisCurrent;
        bpmAnalysisTotal = update.bpmAnalysisTotal;
        bpmAnalysisSucceeded = update.bpmAnalysisSucceeded;
        bpmAnalysisFailed = update.bpmAnalysisFailed;
        if (update.filename[0] != 0) {
            strncpy(bpmAnalysisFile, update.filename, sizeof(bpmAnalysisFile) - 1);
            bpmAnalysisFile[sizeof(bpmAnalysisFile) - 1] = 0;
        }
        break;
    default:
        break;
    }
}

bool marqueeActive = false;  // set while drawing when a name scrolls; the loop then redraws every MARQUEE_MS

// Writes text into out as exactly width columns (out needs width + 1 bytes): padded when it fits,
// otherwise cut with '~', or, when scroll, a window that moves left and wraps around after a gap.
void fitText(char* out, const char* text, int width, bool scroll)
{
    if (width <= 0) {
        out[0] = 0;
        return;
    }
    const int len = static_cast<int>(strlen(text));
    if (len <= width) {
        snprintf(out, width + 1, "%-*s", width, text);
        return;
    }
    if (!scroll) {
        memcpy(out, text, width - 1);
        out[width - 1] = '~';
    } else {
        marqueeActive = true;
        const int span = len + MARQUEE_GAP;
        const int start = static_cast<int>(millis() / MARQUEE_MS % span);
        for (int c = 0; c < width; ++c) {
            const int p = (start + c) % span;
            out[c] = p < len ? text[p] : ' ';
        }
    }
    out[width] = 0;
}

void itemLabel(uint16_t item, char* out, size_t size)
{
    switch (screen) {
    case Screen::ModeList:
        snprintf(out, size, "%s mode%s", modeName(static_cast<PlayMode>(item)),
                 item == static_cast<uint8_t>(playMode) ? " *" : "");
        return;
    case Screen::PlanList:
        snprintf(out, size, "%s%s", TRAIN_PLANS[item].name,
                 playMode == PlayMode::Train && item == trainPlan ? " *" : "");
        return;
    case Screen::VolumeList:
        snprintf(out, size, "Volume %u%%%s", item * VOLUME_STEP,
                 item * VOLUME_STEP == volumePercent ? " *" : "");
        return;
    case Screen::GenreList:
        snprintf(out, size, "%s%s", GENRE_CHOICES[item], item == preferredGenre ? " *" : "");
        return;
    case Screen::BleList:
        if (item >= 2) {
            snprintf(out, size, "OK: Back");
        } else {
            const uint8_t d = item == 0 ? 1 : 0;
            // While down the mode is shown: "Auto" waits for the next retry, "Off" stays down.
            snprintf(out, size, "%s: %s", sourceLabel(static_cast<SensorSource>(d)),
                     bleLink[d] != BleLinkState::Down ? linkLabel(bleLink[d]) : bleAuto[d] ? "Auto" : "Off");
        }
        return;
    case Screen::CustomList:
        if (item >= 2) snprintf(out, size, "OK: Back");
        else snprintf(out, size, "%s: %s", item == 0 ? "PPG" : "IMU", sourceLabel(item == 0 ? ppgSource : imuSource));
        return;
    case Screen::PowerConfirm:
        snprintf(out, size, "%s", item == 0 ? "Cancel" : "Power off");
        return;
    case Screen::DebugList:
        if (item == DebugInfoBar) snprintf(out, size, "Info bar: %s", infoBar ? "On" : "Off");
        else snprintf(out, size, "%s", item == DebugAnalysis ? "Analysis" : "Back");
        return;
    case Screen::AnalysisList:
        snprintf(out, size, "%s", item == AnalysisReanalyzeAll ? "Reanalyze all"
                                  : item == AnalysisClearAll ? "Clear all results"
                                  : item == AnalysisClearOne ? "Clear one song" : "Back");
        return;
    case Screen::AnalysisConfirm:
        if (item == 0) snprintf(out, size, "Cancel");
        else snprintf(out, size, "%s", analysisConfirmItem == AnalysisReanalyzeAll ? "Confirm reanalyze" : "Confirm clear all");
        return;
    case Screen::AgeEdit:
        snprintf(out, size, "Age %u  HRmax %u", static_cast<unsigned>(ageEdit),
                 static_cast<unsigned>(206.9f - 0.67f * ageEdit + 0.5f));
        return;
    case Screen::SongList:
        if (item == 0 || item > musicLibrary.count) {
            snprintf(out, size, "Back");
        } else {
            // "001.mp3     136 Ele": 11-column name (cut with '~', the cursor row scrolls), BPM, first 3
            // letters of the genre ("--" when unknown); 19 columns leave the scroll hint at column 20 clear.
            const MusicEntry& e = musicLibrary.entries[item - 1];
            char name[12];
            fitText(name, e.file, 11, item == cursor);
            char bpmText[8] = "--";
            if (e.bpm != 0) snprintf(bpmText, sizeof(bpmText), "%u", static_cast<unsigned>(e.bpm));
            snprintf(out, size, "%s %3s %.3s", name, bpmText, e.genre[0] ? e.genre : "--");
        }
        return;
    case Screen::SongMenu: {
        const uint8_t action = songMenuItemAt(item);
        if (songMenuIndex < 0 || songMenuIndex >= static_cast<int16_t>(musicLibrary.count)) {
            snprintf(out, size, "OK: Back");
            return;
        }
        const MusicEntry& e = musicLibrary.entries[songMenuIndex];
        if (action == SongPlay) {
            snprintf(out, size, "Play %.14s", e.file);
        } else if (action == SongDouble || action == SongHalve) {
            const uint16_t v = scaledBpm(e.bpm, action == SongDouble);
            if (e.bpm == 0) snprintf(out, size, "%s: BPM unknown", action == SongDouble ? "x2" : "/2");
            else if (v == 0) snprintf(out, size, "%s: out of range", action == SongDouble ? "x2" : "/2");
            else snprintf(out, size, "BPM %s: %u -> %u", action == SongDouble ? "x2" : "/2",
                          static_cast<unsigned>(e.bpm), static_cast<unsigned>(v));
        } else {
            snprintf(out, size, "OK: Back");
        }
        return;
    }
    case Screen::BpmStatus:
        switch (item) {
        case 0:
            snprintf(out, size, "BPM: %s",
                     bpmAnalysisState == BpmAnalysisState::Queued ? "Queued" :
                     bpmAnalysisState == BpmAnalysisState::Running ? "Analyzing" :
                     bpmAnalysisState == BpmAnalysisState::Complete ? "Complete" :
                     bpmAnalysisState == BpmAnalysisState::Failed ? "Failed" :
                     bpmAnalysisState == BpmAnalysisState::Cancelled ? "Cancelled" : "Idle");
            break;
        case 1:
            if (bpmAnalysisState == BpmAnalysisState::Queued)
                snprintf(out, size, "Starting...");
            else if (bpmAnalysisState == BpmAnalysisState::Cancelled)
                snprintf(out, size, "Cancelled");
            else if (bpmAnalysisState == BpmAnalysisState::Complete ||
                     bpmAnalysisState == BpmAnalysisState::Failed)
                snprintf(out, size, "OK %u  Fail %u",
                         bpmAnalysisSucceeded, bpmAnalysisFailed);
            else
                snprintf(out, size, "File %u / %u",
                         bpmAnalysisCurrent, bpmAnalysisTotal);
            break;
        case 2:
            snprintf(out, size, "%.21s", bpmAnalysisFile);
            break;
        default:
            snprintf(out, size, "Back");
            break;
        }
        return;
    default:
        break;
    }

    switch (topItemAt(item)) {
    case TopMode:
        if (playMode == PlayMode::Train) snprintf(out, size, "Mode: %s", TRAIN_PLANS[trainPlan].name);
        else if (trainDone && playMode == PlayMode::Manual) snprintf(out, size, "Mode: Train done");
        else snprintf(out, size, "Mode: %s", modeName(playMode));
        break;
    case TopGenre:
        snprintf(out, size, "Genre: %s", GENRE_CHOICES[preferredGenre]);
        break;
    case TopPlay:
        snprintf(out, size, "%s",
                 audioState == AudioState::Playing ? "Pause"
                 : audioState == AudioState::Paused ? "Resume" : "Stopped");
        break;
    case TopSongs:
        snprintf(out, size, "Songs");
        break;
    case TopSongBpm: {
        const int16_t i = playingLibraryIndex();
        if (i >= 0 && musicLibrary.entries[i].bpm != 0)
            snprintf(out, size, "Song BPM: %u", static_cast<unsigned>(musicLibrary.entries[i].bpm));
        else snprintf(out, size, "Song BPM: --");
        break;
    }
    case TopStop:
        snprintf(out, size, "Stop");
        break;
    case TopVolume:
        snprintf(out, size, "Volume: %u%%", volumePercent);
        break;
    case TopAge:
        snprintf(out, size, "Age: %d", userInfo.age);
        break;
    case TopBpmAnalysis:
        if (bpmAnalysisState == BpmAnalysisState::Queued)
            snprintf(out, size, "BPM: queued");
        else if (bpmAnalysisState == BpmAnalysisState::Running)
            snprintf(out, size, "BPM: %u / %u", bpmAnalysisCurrent, bpmAnalysisTotal);
        else
            snprintf(out, size, "Rescan BPM");
        break;
    case TopBle:
        snprintf(out, size, "BLE");
        break;
    case TopInput:
        snprintf(out, size, "Input: %s", customInput ? "Custom" : sourceLabel(ppgSource));
        break;
    case TopDebug:
        snprintf(out, size, "Debug");
        break;
    case TopPowerOff:
        snprintf(out, size, "Power off");
        break;
    default:
        out[0] = 0;
        break;
    }
}
// The board has no RTC/NTP, so the time shown is sys_ms since boot (millis()),
// same "mmMssS" format as the BM7701 sensor OLED. Minutes wrap at 100.
uint32_t clockSeconds()
{
    return millis() / 1000;
}

// Single-cell Li-ion, linear map 3.6 V = 0% .. 4.0 V = 100%: drops the top and bottom ~10% of the discharge
// curve, clamped outside. Below BATTERY_MIN_MV the ADC is taken as "no battery connected" and "--" is shown.
constexpr uint32_t BATTERY_MIN_MV = 2500;
constexpr uint32_t BATTERY_EMPTY_MV = 3600;
constexpr uint32_t BATTERY_FULL_MV = 4000;

// Returns 0..100, or -1 when no battery is detected. Averages a few reads to tame ADC noise.
int batteryPercent()
{
    uint32_t sum = 0;
    constexpr uint8_t SAMPLES = 8;
    for (uint8_t i = 0; i < SAMPLES; ++i) sum += analogRead(PIN_BATTERY);
    const uint32_t raw = sum / SAMPLES;
    const uint32_t mv = raw * 3300UL / 4096UL * 2;  // core scales mV/3300 to 12 bits; undo the /2 divider
    LOGI(TAG, "battery adc=%lu pin=%lumV battery=%lumV", static_cast<unsigned long>(raw),
         static_cast<unsigned long>(mv / 2), static_cast<unsigned long>(mv));
    if (mv < BATTERY_MIN_MV) return -1;
    if (mv <= BATTERY_EMPTY_MV) return 0;
    if (mv >= BATTERY_FULL_MV) return 100;
    return static_cast<int>((mv - BATTERY_EMPTY_MV) * 100 / (BATTERY_FULL_MV - BATTERY_EMPTY_MV));
}

// Letter box for a BLE link: inverted when up, blinking each second while connecting, plain when down.
void drawLinkIcon(int16_t x, char letter, BleLinkState state)
{
    const bool on = state == BleLinkState::Up || (state == BleLinkState::Connecting && clockSeconds() % 2 == 0);
    if (on) oled.fillRect(x, ICON_Y, 7, 7, 1);
    else oled.drawRect(x, ICON_Y, 7, 7, 1);
    oled.drawChar(x + 1, ICON_Y, letter, on ? 0 : 1, on ? 1 : 0, 1);
}

void drawHeader(char* line, size_t size)
{
    // Play state: triangle, two bars, or a square.
    if (audioState == AudioState::Playing) {
        oled.fillTriangle(0, ICON_Y, 0, ICON_Y + 6, 5, ICON_Y + 3, 1);
    } else if (audioState == AudioState::Paused) {
        oled.fillRect(0, ICON_Y, 2, 7, 1);
        oled.fillRect(4, ICON_Y, 2, 7, 1);
    } else {
        oled.fillRect(0, ICON_Y + 1, 5, 5, 1);
    }
    drawLinkIcon(10, 'C', bleLink[0]);
    drawLinkIcon(19, 'W', bleLink[1]);
    // Hourglass while the BPM / genre scan is queued or running.
    if (bpmAnalysisState == BpmAnalysisState::Queued || bpmAnalysisState == BpmAnalysisState::Running) {
        oled.fillTriangle(30, ICON_Y, 36, ICON_Y, 33, ICON_Y + 3, 1);
        oled.fillTriangle(30, ICON_Y + 6, 36, ICON_Y + 6, 33, ICON_Y + 3, 1);
    }

    const uint32_t sec = clockSeconds();
    snprintf(line, size, "%02u:%02u", (unsigned)(sec / 60 % 100), (unsigned)(sec % 60));
    oled.setCursor(44, ICON_Y);
    oled.print(line);

    // Battery at the far right; refreshed every REFRESH_MS to keep ADC reads cheap.
    static int percent = -1;
    static uint32_t lastBatteryMs = 0;
    static bool batteryRead = false;
    const uint32_t nowMs = millis();
    if (!batteryRead || (uint32_t)(nowMs - lastBatteryMs) >= REFRESH_MS) {
        percent = batteryPercent();
        lastBatteryMs = nowMs;
        batteryRead = true;
    }
    constexpr int16_t BAT_X = OledSh1106::WIDTH - 13;  // 11 px body + 1 px gap + 1 px nub
    oled.drawRect(BAT_X, ICON_Y, 11, 7, 1);
    oled.drawFastVLine(BAT_X + 11, ICON_Y + 2, 3, 1);
    if (percent > 0) oled.fillRect(BAT_X + 2, ICON_Y + 2, (7 * percent + 99) / 100, 3, 1);
    if (percent < 0) snprintf(line, size, "--%%");
    else snprintf(line, size, "%d%%", percent);
    oled.setCursor(BAT_X - 2 - 6 * static_cast<int16_t>(strlen(line)), ICON_Y);
    oled.print(line);

    // Second row: file name on the left, mode status on the right. Enjoy "136>140" (song BPM > target,
    // "--" when unknown), Train "S2/5 3:12" (stage, time left), Demo "L3" (motion level), Manual the song BPM.
    const int16_t i = audioState == AudioState::Stopped ? -1 : playingLibraryIndex();
    char bpmText[8] = "--";
    if (i >= 0 && musicLibrary.entries[i].bpm != 0) snprintf(bpmText, sizeof(bpmText), "%u", musicLibrary.entries[i].bpm);
    char status[24] = "";
    if (playMode == PlayMode::Train) {
        if (trainStage < TRAIN_PLANS[trainPlan].stageCount)
            snprintf(status, sizeof(status), "S%u/%u %u:%02u", static_cast<unsigned>(trainStage + 1),
                     static_cast<unsigned>(TRAIN_PLANS[trainPlan].stageCount), trainRemainingS / 60u,
                     trainRemainingS % 60u);
        else snprintf(status, sizeof(status), "S--");
    } else if (playMode == PlayMode::Demo) {
        if (motionLevel == MOTION_LEVEL_NONE) snprintf(status, sizeof(status), "L-");
        else snprintf(status, sizeof(status), "L%u", static_cast<unsigned>(motionLevel));
    } else if (playMode == PlayMode::Enjoy) {
        if (targetBpm == 0) snprintf(status, sizeof(status), "%s>--", bpmText);
        else snprintf(status, sizeof(status), "%s>%u", bpmText, static_cast<unsigned>(targetBpm));
    } else if (audioState != AudioState::Stopped) {
        snprintf(status, sizeof(status), "%s", bpmText);
    }
    const int statusLen = static_cast<int>(strlen(status));
    const int nameMax = OledSh1106::WIDTH / 6 - statusLen - 1;  // one blank column before the status
    fitText(line, audioState == AudioState::Stopped ? "Stopped" : nowPlaying,
            nameMax < static_cast<int>(size) ? nameMax : static_cast<int>(size) - 1, true);
    oled.setCursor(0, SONG_Y);
    oled.print(line);
    oled.setCursor(OledSh1106::WIDTH - 6 * statusLen, SONG_Y);
    oled.print(status);
    oled.drawFastHLine(0, HEADER_LINE_Y, OledSh1106::WIDTH, 1);
}

void draw()
{
    char line[48];
    const uint16_t count = itemCount();
    const uint8_t menuRows = infoBar ? 4 : 6;

    if (cursor < menuTop) menuTop = cursor;
    if (cursor >= menuTop + menuRows) menuTop = cursor - menuRows + 1;

    oled.clearDisplay();
    oled.setTextSize(1);
    marqueeActive = false;
    const bool volumeBar = screen == Screen::VolumeList;
    oled.setTextColor(1);
    drawHeader(line, sizeof(line));

    if (volumeBar) {
        // Horizontal bar filling from the left; Up/Down adjust, OK leaves.
        snprintf(line, sizeof(line), "Volume %u%%", volumePercent);
        oled.setCursor(2, MENU_Y + 2);
        oled.print(line);
        constexpr int16_t BAR_W = OledSh1106::WIDTH - 4;
        oled.drawRect(2, MENU_Y + 14, BAR_W, 12, 1);
        oled.fillRect(4, MENU_Y + 16, (BAR_W - 4) * volumePercent / 100, 8, 1);
    }

    for (uint8_t row = 0; row < menuRows && !volumeBar; row++) {
        const uint16_t item = menuTop + row;
        if (item >= count) break;
        const int16_t y = MENU_Y + row * 8;
        const bool selected = item == cursor;
        if (selected) oled.fillRect(0, y, OledSh1106::WIDTH, 8, 1);
        oled.setTextColor(selected ? 0 : 1);
        itemLabel(item, line, sizeof(line));
        oled.setCursor(2, y);
        oled.print(line);
        // Scroll hints on the right edge.
        if (row == 0 && menuTop > 0) {
            oled.setCursor(120, y);
            oled.print('^');
        } else if (row == menuRows - 1 && item + 1 < count) {
            oled.setCursor(120, y);
            oled.print('v');
        }
    }

    oled.setTextColor(1);
    if (infoBar) {
        oled.drawFastHLine(0, DIVIDER_Y, OledSh1106::WIDTH, 1);

        if (havePpg) snprintf(line, sizeof(line), "HR:%u SpO2:%u St:%u", heartRate, spo2, ppgStatus);
        else snprintf(line, sizeof(line), "HR:-- SpO2:-- St:-");
        oled.setCursor(0, STATUS_Y[0]);
        oled.print(line);

        // 128 px / 6 px = 21 columns: A:--,--,-- G:--,--,-- fits, real values may clip.
        char accText[24] = "--,--,--";
        char gyroText[24] = "--,--,--";
        if (haveAcc) snprintf(accText, sizeof(accText), "%d,%d,%d", acc[0], acc[1], acc[2]);
        if (haveGyro) snprintf(gyroText, sizeof(gyroText), "%d,%d,%d", gyro[0], gyro[1], gyro[2]);
        snprintf(line, sizeof(line), "A:%s G:%s", accText, gyroText);
        oled.setCursor(0, STATUS_Y[1]);
        oled.print(line);
    }

    const bool full = (uint32_t)(millis() - lastRefreshMs) >= REFRESH_MS;
    const bool ok = full ? oled.refresh() : oled.display();
    if (full) lastRefreshMs = millis();
    if (!ok) {
        // A failed I2C transfer can leave the panel's address registers off (shifted
        // or misplaced rows); repair on the next draw instead of waiting for REFRESH_MS.
        LOGW(TAG, "OLED I2C transfer failed; full refresh scheduled");
        lastRefreshMs = millis() - REFRESH_MS;
    }
}

// ---- Boot / power-off animation and standby ----

constexpr uint32_t ANIM_FRAME_MS = 40;
constexpr uint32_t BOOT_MIN_MS = 3000;
// The bar follows audioBootProgress (SD, catalog, boot scan, NN model, amp) and the menu waits for 100%;
// the timeout only keeps a stuck SD card from holding the menu forever (the NN model load takes seconds).
constexpr uint32_t BOOT_TIMEOUT_MS = 30000;
constexpr uint32_t POWER_OFF_MS = 1100;
constexpr uint32_t WAKE_HOLD_MS = 2000;
constexpr uint32_t BACK_HOLD_MS = 800;
uint32_t okDownMs = 0;     // OK press start, 0 = not tracking (also after wake, while OK is still held)
bool okHeldBack = false;   // this press already went back; its release does nothing

// Keep UI state current while an animation or standby owns the loop.
void drainUpdates()
{
    UiUpdateElement update{};
    while (uiUpdateQueue != nullptr && xQueueReceive(uiUpdateQueue, &update, 0) == pdPASS) applyUpdate(update);
}

// Two lobes plus a point: 4r wide, 3r tall, cy is the lobe centre line. The sides from the point
// (cx, cy + 2r) touch the lobes tangentially at (cx +- 1.6r, cy + 0.8r), so no lobe edge sticks out.
void drawHeart(int16_t cx, int16_t cy, int16_t r)
{
    if (r < 1) {
        oled.drawPixel(cx, cy, 1);
        return;
    }
    const int16_t tx = (8 * r + 2) / 5, ty = cy + (4 * r + 2) / 5;  // rounded: truncating leaves lobe bumps
    oled.fillCircle(cx - r, cy, r, 1);
    oled.fillCircle(cx + r, cy, r, 1);
    oled.fillTriangle(cx - tx, ty, cx + tx, ty, cx, cy + 2 * r, 1);
    oled.fillTriangle(cx - tx, ty, cx, cy, cx + tx, ty, 1);  // fills the notch under where the lobes meet
}

void drawNote(int16_t x, int16_t y)
{
    oled.fillCircle(x, y, 2, 1);
    oled.drawFastVLine(x + 2, y - 8, 9, 1);
    oled.drawLine(x + 2, y - 8, x + 5, y - 5, 1);
}

// One heartbeat trace (P wave, QRS, flat) across x 4..124, drawn up to xEnd.
void drawEcg(int16_t baseY, int16_t xEnd)
{
    static const int8_t POINTS[][2] = {{0, 0},  {36, 0}, {43, -3}, {50, 0},  {60, 0},
                                       {65, 4}, {72, -14}, {79, 8}, {84, 0}, {120, 0}};
    constexpr int16_t X0 = 4;
    for (size_t i = 1; i < sizeof(POINTS) / sizeof(POINTS[0]); ++i) {
        const int16_t x0 = X0 + POINTS[i - 1][0], y0 = baseY + POINTS[i - 1][1];
        int16_t x1 = X0 + POINTS[i][0], y1 = baseY + POINTS[i][1];
        if (x0 >= xEnd) break;
        if (x1 > xEnd) {
            y1 = y0 + (y1 - y0) * (xEnd - x0) / (x1 - x0);
            x1 = xEnd;
        }
        oled.drawLine(x0, y0, x1, y1, 1);
    }
}

// "Lub-dub" every 800 ms: extra heart radius 0..2.
int16_t heartBeat(uint32_t ms)
{
    const uint32_t phase = ms % 800;
    return phase < 120 ? 2 : (phase >= 200 && phase < 300) ? 1 : 0;
}

void printCentered(const char* text, int16_t y)
{
    oled.setCursor((OledSh1106::WIDTH - 6 * static_cast<int16_t>(strlen(text))) / 2, y);
    oled.print(text);
}

// Trace sweeps in, turns into a heart, the heart beats with notes; bar shows boot progress.
void drawBootFrame(uint32_t elapsed, uint8_t progress)
{
    oled.clearDisplay();
    oled.setTextSize(1);
    oled.setTextColor(1);
    if (elapsed < 1000) {
        drawEcg(26, static_cast<int16_t>(4 + 120 * elapsed / 1000));
    } else if (elapsed < 1600) {
        drawHeart(64, 18, static_cast<int16_t>(1 + 6 * (elapsed - 1000) / 600));
    } else {
        drawHeart(64, 18, 6 + heartBeat(elapsed - 1600));
        drawNote(92, 26);
        drawNote(102, 20);
        printCentered("Hear your heart", 38);
    }
    oled.drawRect(14, 52, 100, 8, 1);
    oled.fillRect(16, 54, 96 * progress / 100, 4, 1);
    oled.display();
}

void playBootAnimation()
{
    LOGI(TAG, "boot animation start");
    const uint32_t start = millis();
    for (;;) {
        const uint32_t elapsed = millis() - start;
        const uint8_t stage = audioBootProgress;
        const bool ready = stage >= 100 || elapsed >= BOOT_TIMEOUT_MS;
        uint32_t progress = elapsed * 100 / BOOT_MIN_MS;  // the animation pace caps the bar
        if (progress > stage) progress = stage;
        drawBootFrame(elapsed, static_cast<uint8_t>(progress));
        drainUpdates();
        if (ready && elapsed >= BOOT_MIN_MS) break;
        vTaskDelay(pdMS_TO_TICKS(ANIM_FRAME_MS));
    }
    if (audioBootProgress < 100) LOGW(TAG, "boot not finished (stage %u%%) after %lu ms; menu shown anyway",
             static_cast<unsigned>(audioBootProgress), static_cast<unsigned long>(BOOT_TIMEOUT_MS));
    lastRefreshMs = millis() - REFRESH_MS;  // the menu's first draw resends every page
}

// Heart shrinks with "Goodbye", then the picture collapses to a line like an old CRT.
void playPowerOffAnimation()
{
    const uint32_t start = millis();
    for (uint32_t elapsed = 0; elapsed < POWER_OFF_MS; elapsed = millis() - start) {
        oled.clearDisplay();
        oled.setTextColor(1);
        if (elapsed < 800) {
            drawHeart(64, 18, static_cast<int16_t>(7 * (800 - elapsed) / 800));
            printCentered("Goodbye", 40);
        } else {
            const int16_t w = static_cast<int16_t>(OledSh1106::WIDTH * (POWER_OFF_MS - elapsed) / (POWER_OFF_MS - 800));
            oled.drawFastHLine((OledSh1106::WIDTH - w) / 2, 31, w, 1);
        }
        oled.display();
        vTaskDelay(pdMS_TO_TICKS(ANIM_FRAME_MS));
    }
    oled.clearDisplay();
    oled.display();
}

// Called after controlTask accepted PowerOff. Returns on the main menu after the wake animation.
void runStandby()
{
    playPowerOffAnimation();
    oled.setPower(false);
    LOGI(TAG, "standby: hold OK for %lu ms to wake", static_cast<unsigned long>(WAKE_HOLD_MS));

    bool holding = false;
    uint32_t holdStart = 0;
    for (;;) {
        drainUpdates();
        if (digitalRead(PIN_OK) != LOW) {
            holding = false;
        } else if (!holding) {
            holding = true;
            holdStart = millis();
        } else if ((uint32_t)(millis() - holdStart) >= WAKE_HOLD_MS) {
            break;
        }
        vTaskDelay(pdMS_TO_TICKS(20));
    }

    LOGI(TAG, "OK held: waking");
    oled.setPower(true);
    // controlTask must leave standby (BLE and sensors follow it); retry until the queue takes it.
    while (!sendCommand(UiCommandType::PowerOn)) vTaskDelay(pdMS_TO_TICKS(50));
    playBootAnimation();
    // OK is probably still held: treat every button as down so nothing fires until released.
    for (Button& b : buttons) {
        b.history = 0xFF;
        b.down = true;
    }
    backToTop(TopMode);
}

} // namespace

void UITask(void* parameter) {
    (void)parameter;

    LOGI(TAG, "started; buttons up=D%u down=D%u ok=D%u (INPUT_PULLUP)", static_cast<unsigned>(PIN_UP),
         static_cast<unsigned>(PIN_DOWN), static_cast<unsigned>(PIN_OK));
    for (Button& b : buttons) pinMode(b.pin, INPUT_PULLUP);
    analogReadResolution(12);

    if (!oled.begin()) {
        LOGE(TAG, "OLED (SH1106 @0x%02X) not found on Wire (D3/D4); UI disabled, task exits", OLED_ADDRESS);
        vTaskDelete(nullptr);
    }
    oled.setTextWrap(false);  // a too-long line is clipped at the right edge instead of spilling into the next row
    LOGI(TAG, "OLED initialized (128x64, refresh %lu ms)", static_cast<unsigned long>(REFRESH_MS));
    playBootAnimation();

    bool dirty = true;
    uint32_t lastDrawMs = 0;
    uint32_t lastClockSec = clockSeconds();
    for (;;) {
        const bool upPressed = buttonPressed(buttons[0]);
        const bool downPressed = buttonPressed(buttons[1]);
        if (upPressed || downPressed) {
            LOGD(TAG, "button %s pressed (screen=%s cursor=%u)", upPressed ? "UP" : "DOWN", screenName(screen),
                 static_cast<unsigned>(cursor));
        }
        if (screen == Screen::VolumeList) {
            if (upPressed && volumePercent < 100) {
                volumePercent += VOLUME_STEP;
                LOGI(TAG, "volume -> %u%%", static_cast<unsigned>(volumePercent));
                sendCommand(UiCommandType::SetVolume, volumePercent);
                dirty = true;
            }
            if (downPressed && volumePercent > 0) {
                volumePercent -= VOLUME_STEP;
                LOGI(TAG, "volume -> %u%%", static_cast<unsigned>(volumePercent));
                sendCommand(UiCommandType::SetVolume, volumePercent);
                dirty = true;
            }
        } else if (screen == Screen::AgeEdit) {
            if (upPressed && ageEdit < USER_AGE_MAX) ++ageEdit;
            if (downPressed && ageEdit > USER_AGE_MIN) --ageEdit;
            dirty = dirty || upPressed || downPressed;
        } else if (screen == Screen::BpmStatus) {
            // Only Back is selectable; the other rows are status text.
        } else {
            if (upPressed) {
                cursor = cursor == 0 ? itemCount() - 1 : cursor - 1;
                dirty = true;
            }
            if (downPressed) {
                cursor = cursor + 1 >= itemCount() ? 0 : cursor + 1;
                dirty = true;
            }
        }
        // OK acts on release; held BACK_HOLD_MS in a sub-screen it goes back instead (Top has nothing to leave).
        if (buttonPressed(buttons[2])) {
            okDownMs = millis();
            okHeldBack = false;
        } else if (okDownMs != 0 && !buttons[2].down) {
            okDownMs = 0;
            if (!okHeldBack) {
                okPressMs = millis();
                LOGI(TAG, "OKT 1 OK pressed (screen=%s cursor=%u)", screenName(screen), static_cast<unsigned>(cursor));
                activateItem();
                dirty = true;
            }
        } else if (okDownMs != 0 && !okHeldBack && screen != Screen::Top &&
                   (uint32_t)(millis() - okDownMs) >= BACK_HOLD_MS) {
            okHeldBack = true;
            goBack();
            dirty = true;
        }
        if (powerOffRequested) {
            powerOffRequested = false;
            runStandby();
            dirty = true;
        }

        UiUpdateElement update{};
        while (uiUpdateQueue != nullptr &&
               xQueueReceive(uiUpdateQueue, &update, 0) == pdPASS) {
            applyUpdate(update);
            dirty = true;
        }

        const uint32_t now = millis();
        if ((uint32_t)(now - lastRefreshMs) >= REFRESH_MS) dirty = true;
        if (marqueeActive && (uint32_t)(now - lastDrawMs) >= MARQUEE_MS) dirty = true;
        const uint32_t sec = clockSeconds();
        if (sec != lastClockSec) {
            lastClockSec = sec;
            dirty = true;
        }
        if (dirty &&(uint32_t)(now - lastDrawMs) >= REDRAW_MS) {
            LOGT(TAG, "redraw (screen=%s cursor=%u)", screenName(screen), static_cast<unsigned>(cursor));
            draw();
            dirty = false;
            lastDrawMs = millis();
        }
        vTaskDelay(pdMS_TO_TICKS(POLL_MS));
    }
}
