Squirrel-li/hear-your-heart/firmware/hub8735-ultra/examples/display/oled_sh1106/oled_sh1106.ino

/*
 * 本範程式為Arduino結合1.3吋OLED的範例程式，由傑森創工提供
 * 本程式由wonho-maker改寫的Adafruit函式庫範例進行簡化，若需要進一步學習，建議參考sh1306_128x64_i2c範例
 * 
 * 1，請先安裝Adafruit GFX Library函式庫，可由Arduino IDE裡的「程式管理員」進行安裝
 * 2，請先安裝wonho-maker SH1306函式庫，下載網址：
 *    https://github.com/wonho-maker/Adafruit_SH1106
 * 
 * 粉絲團：https://www.facebook.com/jasonshow
 * 傑森創工購物網：https://www.jmaker.com.tw/
 * 傑森創工部落格：https://blog.jmaker.com.tw/
 */

#include <SPI.h>
#include <Wire.h>
#include <Adafruit_GFX.h>
#include <Adafruit_SH1106.h>

// 設定OLED
#define OLED_RESET -1
Adafruit_SH1106 display(OLED_RESET);

//自訂圖形，從Image2LCD轉過來的，尺寸是128x48
//本範例為了在上方區塊顯示文字，所以圖形就沒有涵蓋整個高度
static const unsigned char PROGMEM logo_bmp[] =
{ 0XFF,0XFF,0XFF,0XFF,0XFF,0X80,0X00,0X00,0X00,0X00,0X00,0X00,0X00,0X00,0X00,0X00,
0XFF,0XFF,0XFF,0XFF,0XFF,0X80,0X00,0X00,0X00,0X00,0X00,0X00,0X00,0X00,0X00,0X00,
0XFF,0XFF,0XF8,0X7F,0XFF,0X80,0X00,0X00,0X00,0X00,0X00,0X00,0X00,0X00,0X00,0X00,
0XFF,0XFF,0XF8,0X3F,0XFF,0X80,0X00,0X00,0X00,0X00,0X00,0X00,0X00,0X00,0X00,0X00,
0XFE,0XFF,0XF8,0X3F,0XFF,0X80,0X00,0X00,0X00,0X00,0X00,0X00,0X00,0X00,0X00,0X00,
0XFE,0X1F,0XFC,0X7F,0XFF,0X80,0X00,0X00,0X00,0X00,0X00,0X00,0X00,0X00,0X00,0X00,
0XFC,0X03,0XFD,0XFF,0XFF,0X80,0X00,0X00,0X00,0X00,0X00,0X00,0X00,0X00,0X00,0X00,
0XE4,0X00,0XFB,0XFF,0XFF,0X83,0X00,0X18,0X00,0X60,0X00,0X38,0X02,0X00,0X00,0X00,
0XE4,0X00,0X1B,0XFF,0XFF,0X83,0X7E,0X18,0X3F,0XFF,0XC0,0XFE,0X03,0X0F,0XFF,0XFC,
0XCC,0X00,0X03,0XFF,0XFF,0X83,0X7F,0XFE,0X7F,0XFF,0XC3,0XC7,0XB3,0X0F,0XFF,0XFC,
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
  display.display();                  // 要有這行才會把文字顯示出來
  delay(1000);
  
  //display.clearDisplay();
  //顯示圖形，x,y,圖形文字,寬,高,1:OLED預設的顏色(這個會依該OLED的顏色來決定)
  display.drawBitmap(0,16,logo_bmp, 128, 48, 1);
  display.display();  // 要有這行才會把文字顯示出來
  delay(1000);
}


void loop() {
  
}
