Squirrel-li/hear-your-heart/(commit log)

2026-09-02 refactor: organize Arduino libraries as submodules
    - Move external libraries into external/libraries
    - Add Adafruit GFX, BusIO, JQ6500, and MAX98357 libraries
    - Update submodule configuration and references
2026-09-02 feat: add audio playback and peripheral test examples
    - Add MAX98357 I2S audio playback with WAV, MP3, and PCM support
    - Add embedded loudspeaker example
    - Add BLE UART Client and SH1106 OLED test sketches
    - Include JQ6500 documentation and audio test files
2026-09-02 fix Arduino cant read MAX98357 lib
2026-09-03 refactor: reorganize project structure and remove obsolete audio code
    - move apps, firmware, docs, and assets into dedicated directories
    - update README and documentation paths
    - remove obsolete MAX98357A library and speaker sources
    - add remote sensor directory placeholders
2026-09-07 test: add BM7701 BLE sensor testing toolkit
    - add BM7701 BLE PowerShell test scripts
    - add browser-based BLE testing page
    - add tablet test launcher
    - document testing procedures and results
    - replace the scripts directory placeholder
2026-09-07 chore: add BM7701 BLE sensor test tooling
    - add BM7701 BLE PowerShell scripts
    - add browser-based BLE test page
    - add testing documentation
    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
2026-09-08 feat: improve remote sensor BLE testing workflow
    - reorganize BM7701 and BW16 sensor documents
    - update Hub8735 BLE scan example
    - enhance BM7701 PowerShell and browser test tools
    - update remote sensor testing documentation
2026-09-09 fix: keep BLE web testing responsive during UART actions
    Queue Web API actions and process BM7701 ACKs from the main loop with timeout cooldown handling. Update the BLE test page layout, UART payload controls, and asynchronous event log rendering, with coverage for queued completion and timeout behavior.
2026-09-09 docs: document HUB8735 external BOOT and RESET control
    Capture confirmed pin mappings, safe electrical interfaces, recommended timing, test sequence, and the boundary between external control and PC-based firmware download.
2026-09-15 feat: integrate BLE sensor driven loudspeaker workflow
    Integrate the HUB8735 embedded loudspeaker application with FreeRTOS, BM7701 BLE sensor data, and non-blocking MAX98357 MP3 playback.
    - add shared application state, queues, and task modules
    - parse BM7701 BLE notifications for PPG and motion sensor data
    - integrate BLE, analysis, control, audio, and UI tasks
    - add BLE notification and BMH08002 PPG examples and references
    - extend the MAX98357 submodule with non-blocking MP3 playback, pause/resume/stop controls, and larger DMA buffering
    - update FreeRTOS documentation and task-flow diagrams
    - remove obsolete task files and add audio test data
    Tested: not run; hardware-dependent v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
2026-09-16 feat: add remote sensor simulator and PPG test data
    Add a Flutter BLE peripheral and PPG simulator for BM7701-compatible remote sensor testing.
    - add Flutter remote sensor simulator with BLE bridge
    - add PPG data playback and dataset boundary tests
    - add PPG test datasets for firmware and simulator use
    - update the MAX98357 submodule to restore 1024-byte I2S DMA pages
    Tested: not run; Flutter, BLE, and hardware validation are still required.
2026-09-30 feat: add HRmax-driven music control and BPM analysis
    Add an HRmax-based sensor-to-playback flow for the HUB8735 application. analysisTask publishes target BPM, controlTask owns song selection and manual override, and audioTask handles playback and reports playback events.
    - add heart-rate zones with hysteresis and target BPM updates
    - route BLE PPG data, target BPM results, and playback events through queues
    - add BPM-based song selection, manual/automatic modes, and failed-track skipping
    - add a standalone MiniBPM MP3 analysis example
    - register the MiniBPM submodule and ignore remote attachment files
    - document the playback flow and confirmed architecture rules
    Tests: not run; HUB8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
2026-10-04 feat: add N76E003 BM7701 sensor firmware and reorganize resources
    Add N76E003 sensor firmware and consolidate BM7701 tools, reference materials, and system diagrams.
    - add BM7701 BLE firmware and N76E003 I2C/UART examples
    - relocate BM7701 test scripts and recorded bench results
    - add BM7701, BMH08002, and N76E003 reference materials
    - add system composition and data flow diagrams
    - update project documentation for the BM7701 sensor scope
    - remove the BW16 plan and obsolete remote_sensor paths
    - ignore ZIP archives and Keil-generated build artifacts
    Tests: not run in this change.
2026-10-06 chore: rename BLE sensor advertising name to BLE_sensor_ITAP
2026-10-06 feat(hub8735): add BLE sensor auto-reconnect and align frame field names
    - Scan/connect/discovery with timeouts and retry on disconnect
    - Rename receive/device timestamps to hub_rx_time_ms/sensor_time_ms and sensorId to msgType
2026-10-06 docs: add BLE sensor-hub protocol reference
2026-10-09 feat(n76e003): add OLED sensor status display
2026-10-09 feat: add sensor UI controls and music library groundwork
    - Add N76E003 OLED page and power controls
    - Show gyro data and add volume adjustment to the HUB8735 UI
    - Add SD music library JSON parsing and persistence scaffolding
    - Document the YAMNet genre analysis proposal and sensor power comparison
    - Add Arduino library metadata for MiniBpm
2026-10-11 feat(sensor): split IMU Acc and Gyro frames
2026-10-11 feat(hub8735): integrate sensor frames and SD library
2026-10-11 feat(hub8735): add OLED manual BPM analysis flow
2026-10-12 fix(hub8735): tolerate empty MP3 frames in BPM analysis and drop duplicate progress report
2026-10-12 feat(hub8735): add OLED manual song selection and OLED I2C recovery
2026-10-12 feat(hub8735): rename sample songs to serial numbers with MiniBPM-based library
2026-10-12 feat(hub8735): show battery percentage on OLED header
2026-10-12 docs(remote_sensor): switch BLE quickref to D00x UART UUID set
2026-10-12 docs(remote_sensor): define msgType 00 cmd, 02 acc+gyro, 03 Acc, 04 Gyro
    Document the new msgType table and the 21-byte combined acc+gyro frame, which needs an MTU of at least 24. 00 is reserved and its payload is not defined yet.
2026-10-12 feat(remote_sensor_simulator): send combined 21-byte acc+gyro frames
    IMU test data is now one type 02 frame per sample instead of a paired Acc/Gyro; the loader and Kotlin payload check accept 20, 21 and 15 bytes.
2026-10-12 feat(hub8735): parse msgType 00-04 and work around duplicate BLE notifications
    Handle the combined acc+gyro frame (02) and the single Acc (03) and Gyro (04) frames, and ignore the reserved cmd frame (00). Remove the sequence-loss statistics.
    The BLE library registers a new GATT client on every addClient() and never unregisters it, so each reconnect adds another copy of every notification and the fourth registration fails. Drop identical back-to-back frames and restart the BLE stack before the registrations run out.
2026-10-12 fix(hub8735): keep sensor data fresh for 15 s instead of 6 s
    The sensor sends one PPG frame per heart-rate cycle, about every 10 s, so a 6 s window marked valid data as stale between frames.
2026-10-12 feat(hub8735): add BMH08002-4 UART control and rate examples
    USB-to-UART bridge sketch with a PC control script, a packet rate counter, a heart-rate-from-CSV script and recorded sample CSVs.
2026-10-12 feat(n76e003): add ble_sensor_hr variant with on-board heart rate
    Copy of ble_sensor whose PPG frame carries a heart rate computed on the N76E003 (ppg_hr.h) and that sends the combined 21-byte acc+gyro frame (msgType 02).
    With more than 256 B of XRAM, SDCC's XINIT copy goes through P2 and misses, so initialised xdata variables started as random values. Re-copy .XINIT to .XISEG with DPTR in _sdcc_external_startup().
2026-10-15 feat(hub8735): add selectable PPG/IMU source with local BMH08002-4 and LSM6DS3
2026-10-18 docs(agents): record DEMO, Train and boot/standby architecture rules
    Also narrow the project scope to the remote sensor simulator.
2026-10-18 feat(n76e003): rename watch board, merge IMU frame and fix XRAM init
    - ble_sensor advertises BLE_watch_ITAP and marks frames with source nibble 1
    - acc+gyro sent as one 21 B frame (msgType 0x12), LSM6DS3 at 0x6B, 12.5 Hz with HP filters
    - re-copy .XINIT with DPTR at startup (SDCC init misses >256 B XRAM)
    - check the PPG module mode at boot and restore timed upload when needed
2026-10-18 feat(remote_sensor_simulator): select watch or chest device type
    Switching the device changes UUID profile, advertised name and the msgType
    source nibble together.
2026-10-18 feat(hub8735): add Demo and Train modes, boot/standby and dual BLE sensors
    - Demo: 5 motion levels from LSM6DS3 (12.5 Hz) switch /demo/DEMO_nn.mp3
    - Train: built-in zone plans (11 min / 5 min demo) owned by controlTask
    - boot animation tied to library readiness, software standby and wake
    - connect chest and watch sensors together, per-device Auto/Manual
    - MAX98357 submodule: single push-pull SD_MODE pin
    - host checks for motion level and train plan; docs for modes and serial commands
2026-10-18 docs: add system architecture overview and HUB8735 pin map
2026-10-18 feat(hub8735): add ZJY180 TFT card UI prototype example
2026-10-22 feat(hub8735): add status/ble/help serial commands and a Web Serial console
    apps/hub_serial_console sends commands and filters logs by level, tag and
    keyword; SERIAL_COMMANDS.md documents the full command set.
2026-10-22 feat(hub8735): switch DEMO motion level within 0.5 s
    0.5 s buckets with a 0.5 s dwell replace the 1 s / 2 s window / 3 s dwell;
    a single-bucket spike still does not switch.
2026-10-22 feat(watch): add experimental ble_sensor_motion and ble_sensor_capture builds
    Both reuse ble_sensor/source/main.c via #include. motion computes a
    motion-aware HR from PPG + 26 Hz ACC (not verified on hardware); capture
    (BLE_capture_ITAP) streams raw PPG + ACC for algorithm validation.
    Includes host/SDCC tests, public-dataset benchmark and results.
2026-10-22 feat(ppg-analyzer): add BLE capture page and motion HR replay prototype
2026-10-22 feat(hub8735): TFT card UI prototype with display task, 40 MHz SPI and recalibrated touch
2026-10-22 docs: align docs with the HUB/watch/external-band scope and current implementation
    Adds review notes to outdated protocol docs and a power-mode planning draft.
2026-10-22 fix(hub8735): drop first 3 decoded frames so BPM does not depend on scan order
2026-10-22 feat(hub8735): default PPG source to Watch and IMU source to Local
2026-10-22 docs: update system architecture diagram to current HUB/watch design
2026-10-23 feat(hub8735): keep BLE links in Auto after disconnect
    Auto links now keep retrying after the link drops instead of switching to Manual; only a user Disconnect or SetManual turns a link Manual. Docs and comments updated to match.
2026-10-23 feat: add BMH08002-4 command relay to capture tool and fix HUB I2C/genre issues
    - ble_sensor_capture: FFF2 opcode 0x02 relays BMH08002-4 commands; capture page gets live waveform, start/stop recording and module settings
    - HUB: share one I2C mutex across Wire/Wire1 (SDK shared TX flag)
    - HUB: genre decode retries from audio start when 1/4 seek lands on a false sync
    - HUB: battery percent maps 3.6-4.0 V linearly
    - update YAMNet model and docs
2026-10-24 feat(hub8735): run playback and track analysis concurrently, scan new files at boot
    - audioTask feeds playback first and runs an analysis step only while >= 1.5 s is buffered
    - playback no longer cancels a scan; analysis requests and BPM corrections are accepted during playback/scan
    - musicBpmAnalysisBusy is raised only while the catalog is being rewritten
    - boot runs a new/unknown scan and preloads the genre NN model when needed; the model stays loaded
    - boot bar follows audioBootProgress init stages and waits for 100% (30 s timeout)
    - bump MAX98357 submodule (3 s ring, ISR volume, immediate pause)
2026-10-24 fix(hub8735): keep separate Helix decoder state for playback and analysis
    - libhmp3.a is built with static buffers: MP3InitDecoder() returns one shared state, so interleaved
    playback and analysis decoding corrupted each other (garbled audio, wrong BPM/genre)
    - helix_state.cpp saves/restores that state (23816 B, sizes checked with static_assert) when switching
    - audioTask decodes in batches: playback refills the ring to 2.5 s, analysis runs until 1.5 s is left
    - if the layout check fails, analysis waits until playback stops or pauses
2026-10-24 feat(n76e003): add swept IR/red PPG waveform page to watch OLED
    - oled_wave.h (shared by ble_sensor and ble_sensor_hr): IR top half, red
    bottom half, one column per PPG sample swept left to right, scaled to
    the previous sweep's range; test_oled_wave.c checks it on a PC
    - P3.0 cycles PPG / IMU / waveform pages; capture shows only the waveform
    - text-page cache is now a 2 B hash per row so motion fits its OLED again
    (XRAM 725/768 B, flash 17,459/18,432 B)
    - ble_capture.html: live waveform sweeps left to right
2026-10-24 fix(n76e003): steady OLED waveform and set BMH08002-4 LED limits at boot
    - oled_wave.h: remove a 16-sample baseline before scaling so drift no
    longer pins the trace to an edge; join sudden cuts (step > 8x the
    usual change, off in motion for flash); a transient I2C error skips
    one column instead of clearing the screen
    - ppg_setup.h (shared by all watch builds): read mode and IR/red LED
    limits at boot, write only the ones that differ (max before min);
    IR 24000-30000, red 29000-30000 were tuned on the capture page
    - ble_capture.html: join sudden cuts in the live waveform (display only)
    - PC checks: test_oled_wave.c, test_ppg_setup.c
2026-10-25 feat(n76e003): add ble_sensor_demo with recorded-PPG playback
    - hold P3.0 at power-up: a 15 s recording (1/2 rate + interpolation) replaces
    the BMH08002-4; motion HR runs on it without ACC
    - one merged text page with a 35-glyph font; raw (no baseline) waveform in DEMO
    - make_demo_ppg.py builds demo_ppg.h from a capture *_raw.json and checks HR
    - NuEclipse --debug adds ~114 B and skips the flash check; keep its .mem ROM <= 18432
2026-10-25 fix(n76e003): lower BMH08002-4 IR LED max to 28000
    IR 24000-28000 / red 29000-30000 gave status 2 and a clean pulse on the
    capture page; ppg_setup.h writes it at boot for all watch builds.
2026-10-25 feat(hub8735): OLED icon row and switchable info bar
    - top row: play state, chest/watch BLE link boxes, BPM-scan hourglass,
    clock and battery
    - Top menu "Info bar" hides the bottom HR / IMU rows for two more menu
    rows; not saved, on again after reboot
2026-10-27 feat(n76e003): ble_sensor_demo battery averaging and per-sweep waveform scaling
2026-10-27 feat(hub8735): spec-based Enjoy zones, pause keeps auto mode, age setting
    - Enjoy zone-to-BPM mapping follows the project plan (heart_zone.h, host check)
    - Pause/Resume stay in Enjoy/Train/Demo; Stop or a manual song leaves to Manual
    - No song with a BPM: play a random one, replace it once a song gets a BPM
    - Boot and wake both enter Enjoy; standby clears the heart-rate target
    - OLED Age setting (6-99, default 25) saved in internal flash
    - BPM analysis status page gets Back (keeps scanning) and Cancel
    - IMU silent 5 s: DEMO motion level unknown, last track not repeated
    - Volume steps in dB
    - Docs: architecture, UI operation, serial commands, DEMO, data format
2026-10-27 feat(hub8735): soften volume curve to -16.7..0 dB
    10..100 % now maps to -16.7..0 dB (was -30..0 dB); the old 50 % is the new 10 %.
    Also logs each command audioTask receives (OKT latency trace).
2026-10-27 feat(hub8735): preferred genre for Enjoy / Train selection
    - SetGenre UI command; controlTask keeps preferredGenre in RAM (Any at boot)
    - song_catalog picks the closest BPM within the genre and falls back to the
    whole library only when the genre has no selectable song
    - GENRE_CHOICES must match MusicGenreClassifier labels
    - controlTask logs each UI command it receives (OKT latency trace)
2026-10-27 feat(hub8735): reorganize OLED menu
    - BLE page keeps only Watch / Chest links; OK toggles Auto / Off
    (one-shot manual connect stays on serial "ble connect")
    - Top-level Input cycles Watch -> Chest -> Local (PPG and IMU together)
    -> Custom; Custom opens a PPG / IMU sub-list
    - Status row removed: Enjoy song>target BPM, Train stage/time and Demo
    level sit on the right of the header song row (no OLED RestartTrain)
    - Genre row for Enjoy / Train
    - Debug menu: Info bar toggle, Reanalyze all / Clear all with confirm;
    BPM status page is view-only (cancel via serial or standby)
    - Docs: HUB_UI_operation, HRMAX_MUSIC_FLOW, ARCH_DIAGRAM_PROMPT
2026-10-27 fix(hub8735): keep long OLED text on its own row
    - Text wrap off: an over-long line is clipped instead of spilling into the next row
    - Songs list name is 11 columns, cut with '~'; the cursor row scrolls it every 300 ms
    - Header song name scrolls when it does not fit beside the mode status
2026-10-27 docs: replace strap ownership notes with ellipsis
2026-10-27 chore: track N76E003 BSP as a submodule and ignore third-party media
